BME-SBT/canbrd/README.md

# canbrd
Universal CAN enabled MCU board
