BME-SBT/canbrd/hardware/hardware.html

# /home/lord/DEV/Solar/canbrd/hardware/hardware.sch

2021. aug. 20., péntek, 15:23:27 CEST

Eeschema 5.1.10-88a1d61d58~88~ubuntu20.04.1

Component Count:71

Ref | Qnty | Value | Part | Footprint | Description | Vendor
C1, C5 | 2 | 100n | Device:C_Small | | Unpolarized capacitor, small symbol
C2, C6 | 2 | 68u | Device:CP_Small | | Polarized capacitor, small symbol
C3, C4 | 2 | 10u | Device:C_Small | Capacitor_SMD:C_0805_2012Metric | Unpolarized capacitor, small symbol
C7, C8, C9, C10, C11 | 5 | 100n | Device:C_Small | Capacitor_SMD:C_0805_2012Metric | Unpolarized capacitor, small symbol
C12 | 1 | 4u7 | Device:C_Small | Capacitor_SMD:C_0805_2012Metric | Unpolarized capacitor, small symbol
C13, C16 | 2 | 1u | Device:C_Small | Capacitor_SMD:C_0805_2012Metric | Unpolarized capacitor, small symbol
C14, C15 | 2 | 10n | Device:C_Small | Capacitor_SMD:C_0805_2012Metric | Unpolarized capacitor, small symbol
C17, C18 | 2 | TBD | Device:C_Small | Capacitor_SMD:C_0805_2012Metric | Unpolarized capacitor, small symbol
D1, D4 | 2 | D | Device:D | | Diode
D2 | 1 | 10V | Device:D_Zener | | Zener diode
D3 | 1 | SMCJ26CA | Device:D_TVS | | Bidirectional transient-voltage-suppression diode
D5 | 1 | 50SQ100 | Device:D_Schottky_Small | | Schottky diode, small symbol
D6, D7 | 2 | TBU-CA040-200-WH | TBU-CA065-200-WH:TBU-CA065-200-WH | DIOC650X400X100N
D8 | 1 | NUP2105L | Power_Protection:NUP2105L | Package_TO_SOT_SMD:SOT-23 | Dual Line CAN Bus Protector, 24Vrwm
D9 | 1 | LTD-4708G | LTD-4708G:LTD-4708G | LTD-470:LED_LTD-4708G
D10 | 1 | RED | Device:LED | LED_SMD:LED_0805_2012Metric | Light emitting diode
D11 | 1 | GREEN | Device:LED | LED_SMD:LED_0805_2012Metric | Light emitting diode
D12 | 1 | BLUE | Device:LED | LED_SMD:LED_0805_2012Metric | Light emitting diode
F1, F3 | 2 | 200mA | Device:Fuse | | Fuse
F2 | 1 | 200mA | Device:Polyfuse | | Resettable fuse, polymeric positive temperature coefficient
FB1 | 1 | 1k@100MHz | Device:Ferrite_Bead | | Ferrite bead
FB2 | 1 | 1k@100MHz | Device:Ferrite_Bead_Small | Inductor_SMD:L_0805_2012Metric | Ferrite bead, small symbol
J1 | 1 | USB_C_Receptacle_USB2.0 | Connector:USB_C_Receptacle_USB2.0 | | USB 2.0-only Type-C Receptacle connector
J2 | 1 | Conn_ST_STDC14 | Connector:Conn_ST_STDC14 | | ST Debug Connector, standard ARM Cortex-M SWD and JTAG interface plus UART
JP1 | 1 | CC1 | Jumper:Jumper_3_Bridged12 | | Jumper, 3-pole, pins 1+2 closed/bridged
JP2 | 1 | CC2 | Jumper:Jumper_3_Bridged12 | | Jumper, 3-pole, pins 1+2 closed/bridged
JP3 | 1 | Jumper_2_Bridged | Jumper:Jumper_2_Bridged | Jumper:SolderJumper-2_P1.3mm_Bridged_RoundedPad1.0x1.5mm | Jumper, 2-pole, closed/bridged
L1 | 1 | 100u | Device:L | | Inductor
Q1 | 1 | Si3129DV | Si3129DV:Si3129DV | Package_SO:TSOP-6_1.65x3.05mm_P0.95mm | P-MOSFET transistor, source/drain/gate, drain connected to mounting plane
Q2 | 1 | PMDT290UNE | Device:Q_DUAL_NMOS_S1G1D2S2G2D1 | Package_TO_SOT_SMD:SOT-666 | Dual NMOS transistor, 6 pin package
R1 | 1 | 1M | Device:R_Small | | Resistor, small symbol
R2 | 1 | 68k | Device:R | | Resistor
R3 | 1 | 384k | Device:R_Small | | Resistor, small symbol
R4 | 1 | 10k | Device:R | | Resistor
R5, R6 | 2 | 5k1 | Device:R | | Resistor
R7, R8, R9, R10, R11, R13, R16, R17 | 8 | 560 | Device:R_Small | Resistor_SMD:R_0805_2012Metric | Resistor, small symbol
R12, R14, R15 | 3 | TBD | Device:R_Small | Resistor_SMD:R_0805_2012Metric | Resistor, small symbol
RV1 | 1 | 60V | Device:Varistor | | Voltage dependent resistor
SW1 | 1 | GDH08S04 | Switch:SW_DIP_x08 | GDH08S04:SOIC127P813X256-16N | 8x DIP Switch, Single Pole Single Throw (SPST) switch, small symbol
SW2 | 1 | RST | Switch:SW_Push | Button_Switch_SMD:SW_SPST_B3U-1000P | Push button switch, generic, two pins
SW3 | 1 | BOOT0 | Switch:SW_Push | Button_Switch_SMD:SW_SPST_B3U-1000P | Push button switch, generic, two pins
SW4 | 1 | USR | Switch:SW_Push | Button_Switch_SMD:SW_SPST_B3U-1000P | Push button switch, generic, two pins
U1 | 1 | MAX5035BUSA | Regulator_Switching:MAX5035BUSA | Package_SO:SOIC-8_3.9x4.9mm_P1.27mm | 1A, High-Efficiency Step-Down DC-DC Converter, 5V fixed output voltage, Vin 76V, SO-8
U2 | 1 | NCP1117-3.3_SOT223 | Regulator_Linear:NCP1117-3.3_SOT223 | Package_TO_SOT_SMD:SOT-223-3_TabPin2 | 1A Low drop-out regulator, Fixed Output 3.3V, SOT-223
U3 | 1 | TCAN1051HGV | TCAN1051HGV:TCAN1051HGV | Package_SO:SOIC-8_3.9x4.9mm_P1.27mm | TCAN1051HGV Fault Protected CAN Transceiver with CAN FD
U4 | 1 | USBLC6-4SC6 | Power_Protection:USBLC6-4SC6 | Package_TO_SOT_SMD:SOT-23-6 | Very low capacitance ESD protection diode, 4 data-line, SOT-23-6
U5 | 1 | STM32G474VET6 | STM32G474VET6:STM32G474VET6 | Package_QFP:TQFP-100_14x14mm_P0.5mm
Y1 | 1 | 25MHz | Device:Crystal_GND24_Small | Crystal:Crystal_SMD_3225-4Pin_3.2x2.5mm_HandSoldering | Four pin crystal, GND on pins 2 and 4, small symbol
