BME-SBT/canbrd/docs/mcu_100.xlsx

Sheet: List
Favorite | Part No | Reference | Unit Price for 10kU (US$) | Package | Flash | RAM | IO | Freq. | ADC 12-bit | CAN | DAC 12-bit | I2C | RTC | SPI | Timer 16-bit | Timer 32-bit | UART | USART | USB Device | USB OTG_FS | USB OTG_HS
1 | STM32F205VE | STM32F205VETx | 4.33 | LQFP100 (14x14mm) | 512 kBytes | 128 kBytes | 82 | 120 MHz | 16 | 2 | 2 | 3 | 1 | 3 | 12 | 2 | 2 | 4 | 0 | 1 | 1
1 | STM32F205VF | STM32F205VFTx | 4.792 | LQFP100 (14x14mm) | 768 kBytes | 128 kBytes | 82 | 120 MHz | 16 | 2 | 2 | 3 | 1 | 3 | 12 | 2 | 2 | 4 | 0 | 1 | 1
1 | STM32F205VG | STM32F205VGTx | 5.255 | LQFP100 (14x14mm) | 1024 kBytes | 128 kBytes | 82 | 120 MHz | 16 | 2 | 2 | 3 | 1 | 3 | 12 | 2 | 2 | 4 | 0 | 1 | 1
1 | STM32F207VE | STM32F207VETx | 4.7 | LQFP100 (14x14mm) | 512 kBytes | 128 kBytes | 82 | 120 MHz | 16 | 2 | 2 | 3 | 1 | 3 | 12 | 2 | 2 | 4 | 0 | 1 | 1
1 | STM32F207VF | STM32F207VFTx | 5.163 | LQFP100 (14x14mm) | 768 kBytes | 128 kBytes | 82 | 120 MHz | 16 | 2 | 2 | 3 | 1 | 3 | 12 | 2 | 2 | 4 | 0 | 1 | 1
1 | STM32F207VG | STM32F207VGTx | 5.626 | LQFP100 (14x14mm) | 1024 kBytes | 128 kBytes | 82 | 120 MHz | 16 | 2 | 2 | 3 | 1 | 3 | 12 | 2 | 2 | 4 | 0 | 1 | 1
1 | STM32F215VE | STM32F215VETx | 4.677 | LQFP100 (14x14mm) | 512 kBytes | 128 kBytes | 82 | 120 MHz | 16 | 2 | 2 | 3 | 1 | 3 | 12 | 2 | 2 | 4 | 0 | 1 | 1
1 | STM32F215VG | STM32F215VGTx | 5.602 | LQFP100 (14x14mm) | 1024 kBytes | 128 kBytes | 82 | 120 MHz | 16 | 2 | 2 | 3 | 1 | 3 | 12 | 2 | 2 | 4 | 0 | 1 | 1
1 | STM32F217VE | STM32F217VETx | 5.047 | LQFP100 (14x14mm) | 512 kBytes | 128 kBytes | 82 | 120 MHz | 16 | 2 | 2 | 3 | 1 | 3 | 12 | 2 | 2 | 4 | 0 | 1 | 1
1 | STM32F217VG | STM32F217VGTx | 5.973 | LQFP100 (14x14mm) | 1024 kBytes | 128 kBytes | 82 | 120 MHz | 16 | 2 | 2 | 3 | 1 | 3 | 12 | 2 | 2 | 4 | 0 | 1 | 1
3 | STM32F405VG | STM32F405VGTx | 5.283 | LQFP100 (14x14mm) | 1024 kBytes | 192 kBytes | 82 | 168 MHz | 16 | 2 | 2 | 3 | 1 | 3 | 12 | 2 | 2 | 4 | 0 | 1 | 1
4 | STM32F407VE | STM32F407VETx | 4.772 | LQFP100 (14x14mm) | 512 kBytes | 192 kBytes | 82 | 168 MHz | 16 | 2 | 2 | 3 | 1 | 3 | 12 | 2 | 2 | 4 | 0 | 1 | 1
5 | STM32F407VG | STM32F407VGTx | 5.623 | LQFP100 (14x14mm) | 1024 kBytes | 192 kBytes | 82 | 168 MHz | 16 | 2 | 2 | 3 | 1 | 3 | 12 | 2 | 2 | 4 | 0 | 1 | 1
2 | STM32F413VG | STM32F413VGTx | 4.816 | LQFP100 (14x14mm) | 1024 kBytes | 320 kBytes | 81 | 100 MHz | 16 | 3 | 2 | 3 | 1 | 5 | 12 | 2 | 6 | 4 | 0 | 1 | 0
2 | STM32F413VH | STM32F413VHTx | 5.348 | LQFP100 (14x14mm) | 1536 kBytes | 320 kBytes | 81 | 100 MHz | 16 | 3 | 2 | 3 | 1 | 5 | 12 | 2 | 6 | 4 | 0 | 1 | 0
3 | STM32F415VG | STM32F415VGTx | 5.602 | LQFP100 (14x14mm) | 1024 kBytes | 192 kBytes | 82 | 168 MHz | 16 | 2 | 2 | 3 | 1 | 3 | 12 | 2 | 2 | 4 | 0 | 1 | 1
4 | STM32F417VE | STM32F417VETx | 5.091 | LQFP100 (14x14mm) | 512 kBytes | 192 kBytes | 82 | 168 MHz | 16 | 2 | 2 | 3 | 1 | 3 | 12 | 2 | 2 | 4 | 0 | 1 | 1
5 | STM32F417VG | STM32F417VGTx | 5.943 | LQFP100 (14x14mm) | 1024 kBytes | 192 kBytes | 82 | 168 MHz | 16 | 2 | 2 | 3 | 1 | 3 | 12 | 2 | 2 | 4 | 0 | 1 | 1
2 | STM32F423VH | STM32F423VHTx | 5.667 | LQFP100 (14x14mm) | 1536 kBytes | 320 kBytes | 81 | 100 MHz | 16 | 3 | 2 | 3 | 1 | 5 | 12 | 2 | 6 | 4 | 0 | 1 | 0
5 | STM32F427VG | STM32F427VGTx | 5.848 | LQFP100 (14x14mm) | 1024 kBytes | 256 kBytes | 82 | 180 MHz | 16 | 2 | 2 | 3 | 1 | 4 | 12 | 2 | 4 | 4 | 0 | 1 | 1
5 | STM32F427VI | STM32F427VITx | 6.7 | LQFP100 (14x14mm) | 2048 kBytes | 256 kBytes | 82 | 180 MHz | 16 | 2 | 2 | 3 | 1 | 4 | 12 | 2 | 4 | 4 | 0 | 1 | 1
4 | STM32F429VE | STM32F429VETx | 5.295 | LQFP100 (14x14mm) | 512 kBytes | 256 kBytes | 82 | 180 MHz | 16 | 2 | 2 | 3 | 1 | 4 | 12 | 2 | 4 | 4 | 0 | 1 | 1
5 | STM32F429VG | STM32F429VGTx | 6.146 | LQFP100 (14x14mm) | 1024 kBytes | 256 kBytes | 82 | 180 MHz | 16 | 2 | 2 | 3 | 1 | 4 | 12 | 2 | 4 | 4 | 0 | 1 | 1
5 | STM32F429VI | STM32F429VITx | 6.998 | LQFP100 (14x14mm) | 2048 kBytes | 256 kBytes | 82 | 180 MHz | 16 | 2 | 2 | 3 | 1 | 4 | 12 | 2 | 4 | 4 | 0 | 1 | 1
5 | STM32F437VG | STM32F437VGTx | 6.168 | LQFP100 (14x14mm) | 1024 kBytes | 256 kBytes | 82 | 180 MHz | 16 | 2 | 2 | 3 | 1 | 4 | 12 | 2 | 4 | 4 | 0 | 1 | 1
5 | STM32F437VI | STM32F437VITx | 7.019 | LQFP100 (14x14mm) | 2048 kBytes | 256 kBytes | 82 | 180 MHz | 16 | 2 | 2 | 3 | 1 | 4 | 12 | 2 | 4 | 4 | 0 | 1 | 1
5 | STM32F439VG | STM32F439VGTx | 6.466 | LQFP100 (14x14mm) | 1024 kBytes | 256 kBytes | 82 | 180 MHz | 16 | 2 | 2 | 3 | 1 | 4 | 12 | 2 | 4 | 4 | 0 | 1 | 1
5 | STM32F439VI | STM32F439VITx | 7.317 | LQFP100 (14x14mm) | 2048 kBytes | 256 kBytes | 82 | 180 MHz | 16 | 2 | 2 | 3 | 1 | 4 | 12 | 2 | 4 | 4 | 0 | 1 | 1
4 | STM32F446VE | STM32F446VETx | 3.982 | LQFP100 (14x14mm) | 512 kBytes | 128 kBytes | 81 | 180 MHz | 16 | 2 | 2 | 3 | 1 | 4 | 12 | 2 | 2 | 4 | 0 | 1 | 1
2 | STM32F722VE | STM32F722VETx | 4.685 | LQFP100 (14x14mm) | 512 kBytes | 256 kBytes | 82 | 216 MHz | 16 | 1 | 2 | 3 | 1 | 4 | 12 | 2 | 4 | 4 | 0 | 1 | 1
2 | STM32F723VC | STM32F723VCTx | 4.429 | LQFP100 (14x14mm) | 512 kBytes | 256 kBytes | 79 | 216 MHz | 16 | 1 | 2 | 3 | 1 | 4 | 11 | 2 | 4 | 4 | 0 | 1 | 1
2 | STM32F723VE | STM32F723VETx | 4.685 | LQFP100 (14x14mm) | 512 kBytes | 256 kBytes | 79 | 216 MHz | 16 | 1 | 2 | 3 | 1 | 4 | 11 | 2 | 4 | 4 | 0 | 1 | 1
2 | STM32F732VE | STM32F732VETx | 4.791 | LQFP100 (14x14mm) | 512 kBytes | 256 kBytes | 82 | 216 MHz | 16 | 1 | 2 | 3 | 1 | 4 | 12 | 2 | 4 | 4 | 0 | 1 | 1
2 | STM32F733VE | STM32F733VETx | 5.11 | LQFP100 (14x14mm) | 512 kBytes | 256 kBytes | 79 | 216 MHz | 16 | 1 | 2 | 3 | 1 | 4 | 11 | 2 | 4 | 4 | 0 | 1 | 1
4 | STM32F745VE | STM32F745VETx | 5.114 | LQFP100 (14x14mm) | 512 kBytes | 320 kBytes | 82 | 216 MHz | 16 | 2 | 2 | 4 | 1 | 4 | 12 | 2 | 4 | 4 | 0 | 1 | 1
5 | STM32F745VG | STM32F745VGTx | 5.965 | LQFP100 (14x14mm) | 1024 kBytes | 320 kBytes | 82 | 216 MHz | 16 | 2 | 2 | 4 | 1 | 4 | 12 | 2 | 4 | 4 | 0 | 1 | 1
4 | STM32F746VE | STM32F746VETx | 5.412 | LQFP100 (14x14mm) | 512 kBytes | 320 kBytes | 82 | 216 MHz | 16 | 2 | 2 | 4 | 1 | 4 | 12 | 2 | 4 | 4 | 0 | 1 | 1
5 | STM32F746VG | STM32F746VGTx | 6.263 | LQFP100 (14x14mm) | 1024 kBytes | 320 kBytes | 82 | 216 MHz | 16 | 2 | 2 | 4 | 1 | 4 | 12 | 2 | 4 | 4 | 0 | 1 | 1
5 | STM32F756VG | STM32F756VGTx | 6.583 | LQFP100 (14x14mm) | 1024 kBytes | 320 kBytes | 82 | 216 MHz | 16 | 2 | 2 | 4 | 1 | 4 | 12 | 2 | 4 | 4 | 0 | 1 | 1
5 | STM32F765VG | STM32F765VGTx | 6.346 | LQFP100 (14x14mm) | 1024 kBytes | 512 kBytes | 82 | 216 MHz | 16 | 3 | 2 | 4 | 1 | 5 | 12 | 2 | 4 | 4 | 0 | 1 | 1
5 | STM32F765VI | STM32F765VITx | 7.198 | LQFP100 (14x14mm) | 2048 kBytes | 512 kBytes | 82 | 216 MHz | 16 | 3 | 2 | 4 | 1 | 5 | 12 | 2 | 4 | 4 | 0 | 1 | 1
5 | STM32F767VG | STM32F767VGTx | 6.577 | LQFP100 (14x14mm) | 1024 kBytes | 512 kBytes | 82 | 216 MHz | 16 | 3 | 2 | 4 | 1 | 5 | 12 | 2 | 4 | 4 | 0 | 1 | 1
5 | STM32F767VI | STM32F767VITx | 7.428 | LQFP100 (14x14mm) | 2048 kBytes | 512 kBytes | 82 | 216 MHz | 16 | 3 | 2 | 4 | 1 | 5 | 12 | 2 | 4 | 4 | 0 | 1 | 1
5 | STM32F777VI | STM32F777VITx | 7.747 | LQFP100 (14x14mm) | 2048 kBytes | 512 kBytes | 82 | 216 MHz | 16 | 3 | 2 | 4 | 1 | 5 | 12 | 2 | 4 | 4 | 0 | 1 | 1
3 | STM32L4P5VE | STM32L4P5VETx | 3.921 | LQFP100 (14x14mm) | 512 kBytes | 320 kBytes | 83 | 120 MHz | 16 | 1 | 2 | 4 | 1 | 3 | 9 | 2 | 2 | 3 | 0 | 1 | 0
4 | STM32L4R5VG | STM32L4R5VGTx | 5.675 | LQFP100 (14x14mm) | 1024 kBytes | 640 kBytes | 83 | 120 MHz | 16 | 1 | 2 | 4 | 1 | 3 | 9 | 2 | 2 | 3 | 0 | 1 | 0
4 | STM32L4R5VI | STM32L4R5VITx | 6.527 | LQFP100 (14x14mm) | 2048 kBytes | 640 kBytes | 83 | 120 MHz | 16 | 1 | 2 | 4 | 1 | 3 | 9 | 2 | 2 | 3 | 0 | 1 | 0
4 | STM32L4R7VI | STM32L4R7VITx | 6.846 | LQFP100 (14x14mm) | 2048 kBytes | 640 kBytes | 83 | 120 MHz | 16 | 1 | 2 | 4 | 1 | 3 | 9 | 2 | 2 | 3 | 0 | 1 | 0
4 | STM32L4S5VI | STM32L4S5VITx | 6.633 | LQFP100 (14x14mm) | 2048 kBytes | 640 kBytes | 83 | 120 MHz | 16 | 1 | 2 | 4 | 1 | 3 | 9 | 2 | 2 | 3 | 0 | 1 | 0
4 | STM32L4S7VI | STM32L4S7VITx | 6.952 | LQFP100 (14x14mm) | 2048 kBytes | 640 kBytes | 83 | 120 MHz | 16 | 1 | 2 | 4 | 1 | 3 | 9 | 2 | 2 | 3 | 0 | 1 | 0
4 | STM32G473VE | STM32G473VETx | 3.97 | LQFP100 (14x14mm) | 512 kBytes | 128 kBytes | 86 | 170 MHz | 42 | 0 | 3 | 4 | 1 | 4 | 10 | 2 | 2 | 3 | 1 | 0 | 0
4 | STM32G474VE | STM32G474VETx | 4.08 | LQFP100 (14x14mm) | 512 kBytes | 128 kBytes | 86 | 170 MHz | 42 | 0 | 3 | 4 | 1 | 4 | 10 | 2 | 2 | 3 | 1 | 0 | 0
4 | STM32G483VE | STM32G483VETx | 4.085 | LQFP100 (14x14mm) | 512 kBytes | 128 kBytes | 86 | 170 MHz | 42 | 0 | 3 | 4 | 1 | 4 | 10 | 2 | 2 | 3 | 1 | 0 | 0
4 | STM32G484VE | STM32G484VETx | 4.196 | LQFP100 (14x14mm) | 512 kBytes | 128 kBytes | 86 | 170 MHz | 42 | 0 | 3 | 4 | 1 | 4 | 10 | 2 | 2 | 3 | 1 | 0 | 0

Sheet: Filters
Filter | Value | User Selected
BigFamily | STM32 | Y
Package | LQFP100 (14x14mm) | Y
Core | Arm Cortex-M3, Arm Cortex-M4, Arm Cortex-M7 | N
Series | STM32F2, STM32F4, STM32F7, STM32L4+ | N
Line | STM32F2x5, STM32F2x7, STM32F405/415, STM32F407/417, STM32F413/423, STM32F427/437, STM32F429/439, STM32F446, STM32F7x2, STM32F7x3, STM32F7x5, STM32F7x6, STM32F7x7, STM32L4P5/Q5, STM32L4R5/S5, STM32L4R7/S7 | N
Freq | 100 to 216 | Y
Flash | 512 to 2048 | Y
Ram | 128 to 640 | Y
Price | 3.921 to 7.747 | N
IO | 79 to 83 | N
Eeprom | 0 to 0 | N
ADC 12-bit | 16 | Y
AES | 0 | N
CAN | 1 | Y
COMP | 0 | N
DAC 12-bit | 1 | Y
DCMI | 0 | N
DES/TDES | 0 | N
DFSDM | 0 | N
Ethernet | 0 | N
FMC | 0 | N
FMPI2C | 0 | N
FSMC | 0 | N
HDMI CEC | 0 | N
HMAC | 0 | N
I2C | 0 | N
I2S | 0 | N
IRTIM | 0 | N
LPTIM | 0 | N
LPUART | 0 | N
MD5 | 0 | N
OPAMP | 0 | N
QUADSPI | 0 | N
RTC | 0 | N
SAI | 0 | N
SDIO | 0 | N
SDMMC | 0 | N
SHA | 0 | N
SPDIFRX | 0 | N
SPI | 0 | N
TFT LCD | 0 | N
TRNG | 0 | N
Timer 16-bit | 0 | N
Timer 32-bit | 0 | N
Touch Sensing | 0 | N
UART | 0 | N
USART | 0 | N
USB OTG_FS | 0 | N
USB OTG_HS | 0 | N
