BME-SBT/canbrd/docs/mcu_100_g4.xlsx

Sheet: List
List of MCUs selection: 4 items. Database version: Mon Jun 07 10:53:21 CEST 2021
Favorite | Part No | Reference | Unit Price for 10kU (US$) | Package | Flash | RAM | IO | Freq. | ADC 12-bit | ADC 16-bit | CAN | DAC 12-bit | I2C | RTC | SPI | Timer 16-bit | Timer 32-bit | UART | USART | USB Device | USB OTG_FS | USB OTG_HS
 | STM32G473VE | STM32G473VETx | 3.97 | LQFP100 (14x14mm) | 512 kBytes | 128 kBytes | 86 | 170 MHz | 42 | 0 | 0 | 3 | 4 | 1 | 4 | 10 | 2 | 2 | 3 | 1 | 0 | 0
* | STM32G474VE | STM32G474VETx | 4.08 | LQFP100 (14x14mm) | 512 kBytes | 128 kBytes | 86 | 170 MHz | 42 | 0 | 0 | 3 | 4 | 1 | 4 | 10 | 2 | 2 | 3 | 1 | 0 | 0
 | STM32G483VE | STM32G483VETx | 4.085 | LQFP100 (14x14mm) | 512 kBytes | 128 kBytes | 86 | 170 MHz | 42 | 0 | 0 | 3 | 4 | 1 | 4 | 10 | 2 | 2 | 3 | 1 | 0 | 0
 | STM32G484VE | STM32G484VETx | 4.196 | LQFP100 (14x14mm) | 512 kBytes | 128 kBytes | 86 | 170 MHz | 42 | 0 | 0 | 3 | 4 | 1 | 4 | 10 | 2 | 2 | 3 | 1 | 0 | 0

Sheet: Filters
List of MCUs selection: 4 items. Database version: Mon Jun 07 10:53:21 CEST 2021
Filter | Value | User Selected
BigFamily | STM32 | Y
Package | LQFP100 (14x14mm) | Y
Series | STM32G4 | Y
Core | Arm Cortex-M4 | N
Line | STM32G4x3, STM32G4x4 | N
Freq | 100 to 216 | Y
Flash | 512 to 2048 | Y
Ram | 128 to 640 | Y
Price | 3.97 to 4.196 | N
IO | 86 to 86 | N
Eeprom | 0 to 0 | N
ADC 12-bit | 0 | N
AES | 0 | N
COMP | 0 | N
DAC 12-bit | 0 | N
FMC | 0 | N
HRTIM | 0 | N
I2C | 0 | N
I2S | 0 | N
IRTIM | 0 | N
LPTIM | 0 | N
LPUART | 0 | N
OPAMP | 0 | N
QUADSPI | 0 | N
RTC | 0 | N
SAI | 0 | N
SPI | 0 | N
Timer 16-bit | 0 | N
Timer 32-bit | 0 | N
UART | 0 | N
USART | 0 | N
USB Device | 0 | N
