BME-SBT/canbrd/docs/can_transciever.xlsx

Manufacturer | Part No. | Max data rate | Isolation | Iso Power | Common V | Bus Fault V | ESD V | Price | Price w/ iso | Lead time | power iso | 1000 Ft | PDP1-S5-S5-M
Analog | ADM3057E | 12M | 3.00 kVrms | Y | ±25 V | ±40 V |  | 3600 Ft | 3600 Ft | short | io iso | 600 Ft
Analog | ADM3055E | 12M | 5.00 kVrms | Y | ±25 V | ±40 V |  | 4200 Ft | 4200 Ft | short | power+io iso | 2000 Ft | ADuM5211
Analog | ADM3050E | 12M | 5.70 kVrms |  | ±25 V | ±40 V |  | 1600 Ft | 2600 Ft | short
Analog | ADM3058E | 12M | 5.70 kVrms |  | ±25 V | ±40 V | 15 kV | 1600 Ft | 2600 Ft | LONG
NXP | TJA1052i | 5M | 5.00 kVrms |  | ±25 V | ±58 V | 8 kV | 2100 Ft | 3100 Ft | LONG
NXP | TJA1042T | 5M |  |  |  | ±58 V | 8 kV | 450 Ft | 2450 Ft | LONG
NXP | TJA1049T | 5M |  |  |  | ±58 V | 8 kV | 500 Ft | 2500 Ft | LONG
NXP | TJA1051T | 5M |  |  |  | ±58 V | 8 kV | 380 Ft | 2380 Ft | LONG
Microchip | MCP2558FD | 8M |  |  |  | ±58 V | 8 kV | 250 Ft | 2250 Ft | short
Texas Instruments | ISO1042 | 5M | 5.00 kVrms |  | ±30 V | ±70 V | 16 kV | 1500 Ft | 2500 Ft | long
Texas Instruments | TCAN1042HGV | 5M |  |  | ±30 V | ±70 V | 15 kV | 600 Ft | 2600 Ft | mid
Texas Instruments | TCAN1051HGV | 5M |  |  | ±30 V | ±70 V | 15 kV | 600 Ft | 2600 Ft | mid
