BME-SBT/canbrd/docs/mcu_g4.xlsx

Sheet: List
List of MCUs selection: 15 items. Database version: Mon Jun 07 10:53:21 CEST 2021
Favorite | Part No | Reference | Unit Price for 10kU (US$) | Package | Flash | RAM | IO | Freq. | ADC 12-bit | CAN | DAC 12-bit | I2C | RTC | SPI | Timer 16-bit | Timer 32-bit | UART | USART | USB Device | USB OTG_FS | USB OTG_HS
 | STM32G431V6 | STM32G431V6Tx | 2.459 | LQFP100 (14x14mm) | 32 kBytes | 32 kBytes | 86 | 170 MHz | 23 | 0 | 2 | 3 | 1 | 3 | 9 | 1 | 1 | 3 | 1 | 0 | 0
 | STM32G431V8 | STM32G431V8Tx | 2.574 | LQFP100 (14x14mm) | 64 kBytes | 32 kBytes | 86 | 170 MHz | 23 | 0 | 2 | 3 | 1 | 3 | 9 | 1 | 1 | 3 | 1 | 0 | 0
 | STM32G431VB | STM32G431VBTx | 2.76 | LQFP100 (14x14mm) | 128 kBytes | 32 kBytes | 86 | 170 MHz | 23 | 0 | 2 | 3 | 1 | 3 | 9 | 1 | 1 | 3 | 1 | 0 | 0
 | STM32G441VB | STM32G441VBTx | 2.875 | LQFP100 (14x14mm) | 128 kBytes | 32 kBytes | 86 | 170 MHz | 23 | 0 | 2 | 3 | 1 | 3 | 9 | 1 | 1 | 3 | 1 | 0 | 0
 | STM32G473VB | STM32G473VBTx | 3.09 | LQFP100 (14x14mm) | 128 kBytes | 128 kBytes | 86 | 170 MHz | 42 | 0 | 3 | 4 | 1 | 4 | 10 | 2 | 2 | 3 | 1 | 0 | 0
 | STM32G473VC | STM32G473VCTx | 3.414 | LQFP100 (14x14mm) | 256 kBytes | 128 kBytes | 86 | 170 MHz | 42 | 0 | 3 | 4 | 1 | 4 | 10 | 2 | 2 | 3 | 1 | 0 | 0
 | STM32G473VE | STM32G473VETx | 3.97 | LQFP100 (14x14mm) | 512 kBytes | 128 kBytes | 86 | 170 MHz | 42 | 0 | 3 | 4 | 1 | 4 | 10 | 2 | 2 | 3 | 1 | 0 | 0
 | STM32G474VB | STM32G474VBTx | 3.2 | LQFP100 (14x14mm) | 128 kBytes | 128 kBytes | 86 | 170 MHz | 42 | 0 | 3 | 4 | 1 | 4 | 10 | 2 | 2 | 3 | 1 | 0 | 0
 | STM32G474VC | STM32G474VCTx | 3.524 | LQFP100 (14x14mm) | 256 kBytes | 128 kBytes | 86 | 170 MHz | 42 | 0 | 3 | 4 | 1 | 4 | 10 | 2 | 2 | 3 | 1 | 0 | 0
* | STM32G474VE | STM32G474VETx | 4.08 | LQFP100 (14x14mm) | 512 kBytes | 128 kBytes | 86 | 170 MHz | 42 | 0 | 3 | 4 | 1 | 4 | 10 | 2 | 2 | 3 | 1 | 0 | 0
 | STM32G483VE | STM32G483VETx | 4.085 | LQFP100 (14x14mm) | 512 kBytes | 128 kBytes | 86 | 170 MHz | 42 | 0 | 3 | 4 | 1 | 4 | 10 | 2 | 2 | 3 | 1 | 0 | 0
 | STM32G484VE | STM32G484VETx | 4.196 | LQFP100 (14x14mm) | 512 kBytes | 128 kBytes | 86 | 170 MHz | 42 | 0 | 3 | 4 | 1 | 4 | 10 | 2 | 2 | 3 | 1 | 0 | 0
 | STM32G491VC | STM32G491VCTx | 3.084 | LQFP100 (14x14mm) | 256 kBytes | 112 kBytes | 86 | 170 MHz | 36 | 0 | 2 | 3 | 1 | 3 | 10 | 1 | 2 | 3 | 1 | 0 | 0
 | STM32G491VE | STM32G491VETx | 3.639 | LQFP100 (14x14mm) | 512 kBytes | 112 kBytes | 86 | 170 MHz | 36 | 0 | 2 | 3 | 1 | 3 | 10 | 1 | 2 | 3 | 1 | 0 | 0
 | STM32G4A1VE | STM32G4A1VETx | 3.755 | LQFP100 (14x14mm) | 512 kBytes | 112 kBytes | 86 | 170 MHz | 36 | 0 | 2 | 3 | 1 | 3 | 10 | 1 | 2 | 3 | 1 | 0 | 0

Sheet: Filters
List of MCUs selection: 15 items. Database version: Mon Jun 07 10:53:21 CEST 2021
Filter | Value | User Selected
BigFamily | STM32 | Y
Series | STM32G4 | Y
Package | LQFP100 (14x14mm) | Y
Core | Arm Cortex-M4 | N
Line | STM32G4x1, STM32G4x3, STM32G4x4 | N
Price | 2.459 to 4.196 | N
IO | 86 to 86 | N
Eeprom | 0 to 0 | N
Flash | 32 to 512 | N
Ram | 32 to 128 | N
Freq | 170 to 170 | N
ADC 12-bit | 0 | N
AES | 0 | N
COMP | 0 | N
DAC 12-bit | 0 | N
FMC | 0 | N
HRTIM | 0 | N
I2C | 0 | N
I2S | 0 | N
IRTIM | 0 | N
LPTIM | 0 | N
LPUART | 0 | N
OPAMP | 0 | N
QUADSPI | 0 | N
RTC | 0 | N
SAI | 0 | N
SPI | 0 | N
Timer 16-bit | 0 | N
Timer 32-bit | 0 | N
UART | 0 | N
USART | 0 | N
USB Device | 0 | N
