BME-SBT/canbrd/hardware/parts/218-8LPS/218-8.STEP

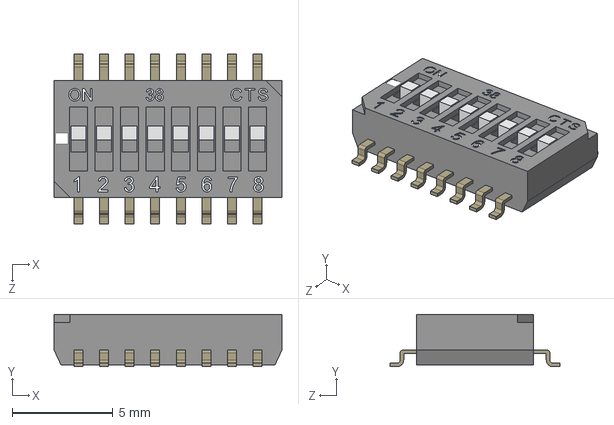
[picture p1: CAD file, 2021-08-23]
hardware/parts/218-8LPS/218-8.STEP
11.3 x 2.60 x 8.44 mm
