BME-SBT/canbrd/hardware/parts/GDH08S04/c-1571983-10-b-3d.stp

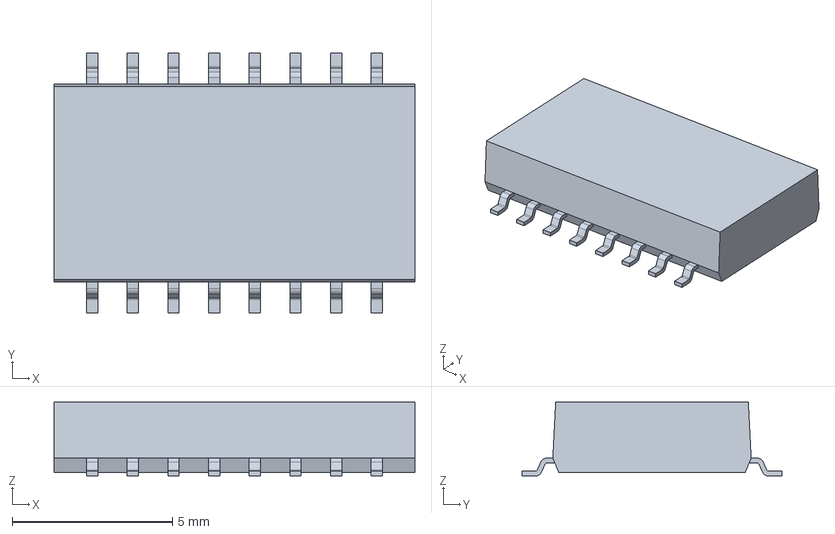
[picture p2: CAD file, 2021-08-17]
hardware/parts/GDH08S04/c-1571983-10-b-3d.stp
11.3 x 8.13 x 2.31 mm
