BME-SBT/canbrd/hardware/parts/Littelfuse-154/0154.500DR.STEP

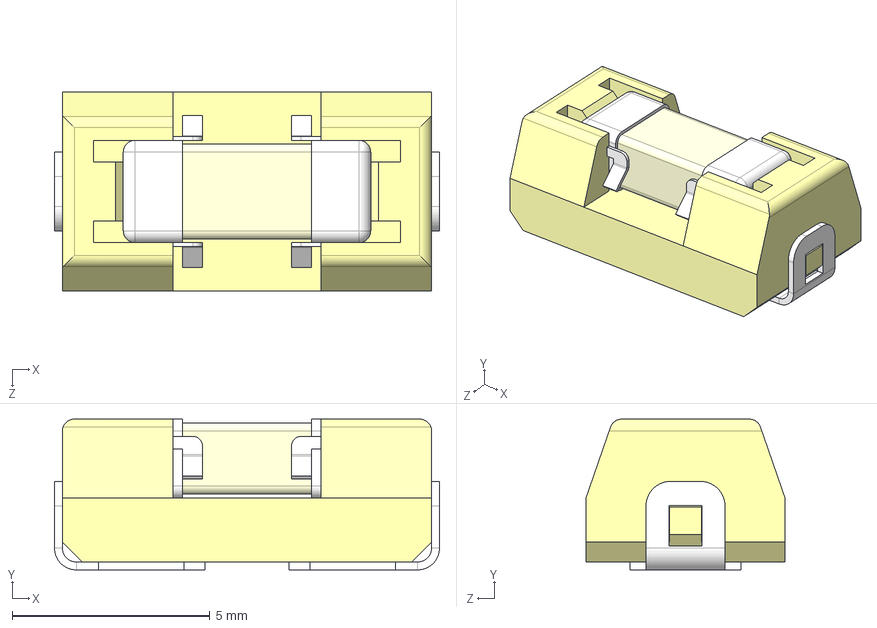
[picture p3: CAD file, 2021-08-23]
hardware/parts/Littelfuse-154/0154.500DR.STEP
9.73 x 3.81 x 5.03 mm
