BME-SBT/canbrd/hardware/parts/LTD-470/LTD-4708G.step

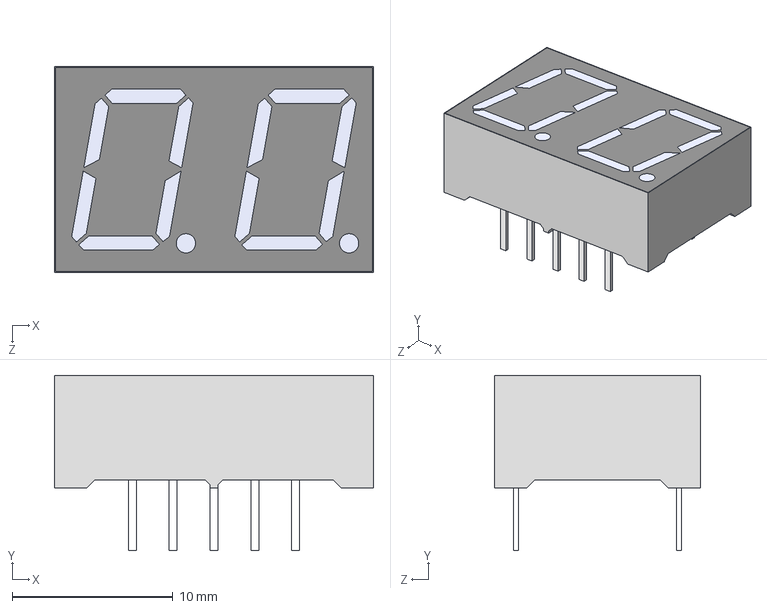
[picture p4: CAD file, 2021-08-17]
hardware/parts/LTD-470/LTD-4708G.step
19.9 x 10.9 x 12.8 mm
