BME-SBT/canbrd/hardware/parts/MAX17521/21-0201A_MXM.step

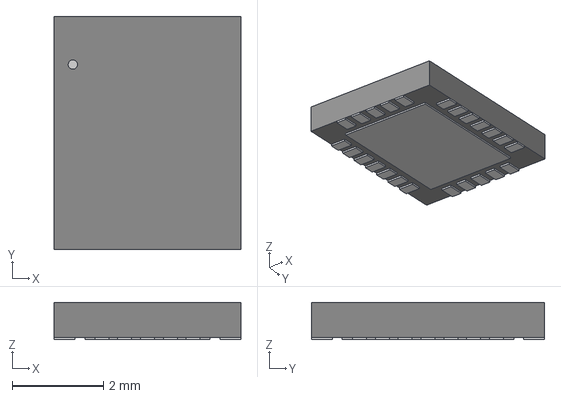
[picture p5: CAD file, 2021-08-22]
hardware/parts/MAX17521/21-0201A_MXM.step
4.09 x 5.11 x 0.815 mm
