BME-SBT/canbrd/hardware/parts/NRS8040/nrs8040.step

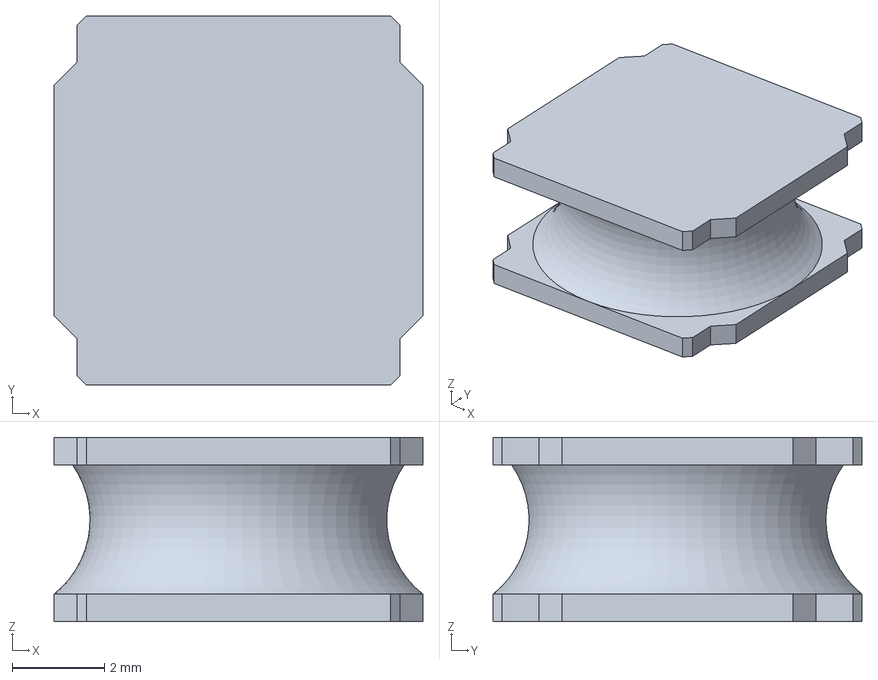
[picture p6: CAD file, 2021-08-23]
hardware/parts/NRS8040/nrs8040.step
8.00 x 8.00 x 4.00 mm
