BME-SBT/canbrd/hardware/parts/RKB2SJ/RKB2SJM250SMTR LFS.stp

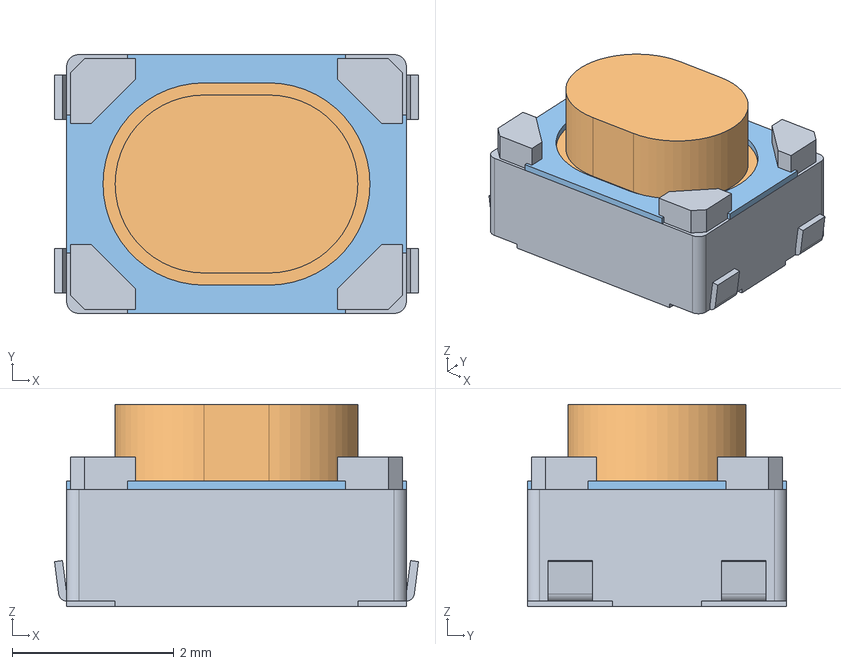
[picture p7: CAD file, 2021-08-23]
hardware/parts/RKB2SJ/RKB2SJM250SMTR LFS.stp
4.50 x 3.20 x 2.50 mm
JIZUO
ANNIU
GAIBAN
