BME-SBT/canbrd/hardware/parts/STM32G474VET6/STM32G474VET6.step

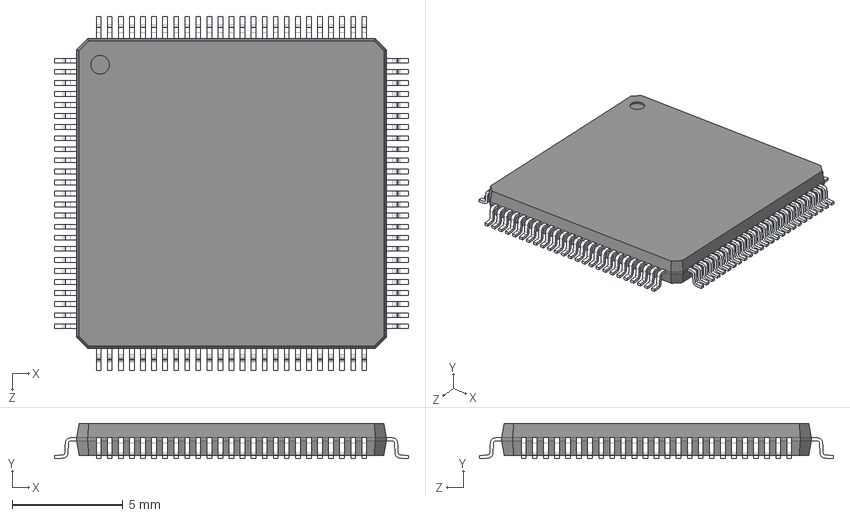
[picture p8: CAD file, 2021-08-16]
hardware/parts/STM32G474VET6/STM32G474VET6.step
16.0 x 1.60 x 16.0 mm
