BME-SBT/canbrd/hardware/parts/TBU-CA/tbu-ca-color.step

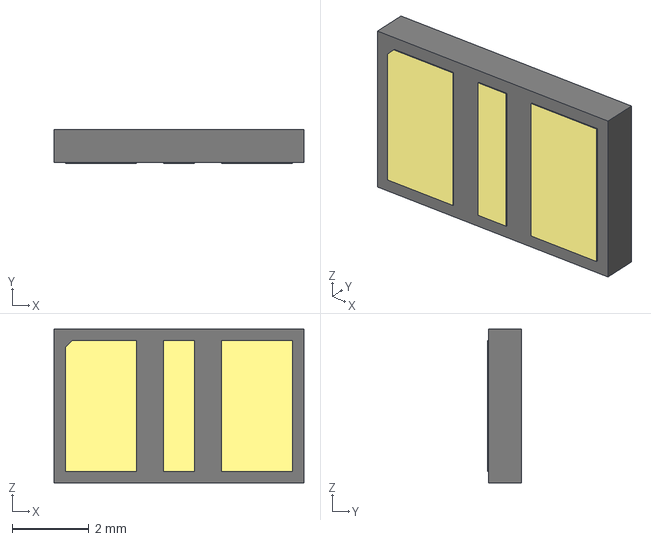
[picture p9: CAD file, 2021-08-23]
hardware/parts/TBU-CA/tbu-ca-color.step
6.50 x 0.875 x 4.00 mm
