BME-SBT/canbrd/hardware/parts/USB4085-GF-A--3DModel-STEP-56544.STEP

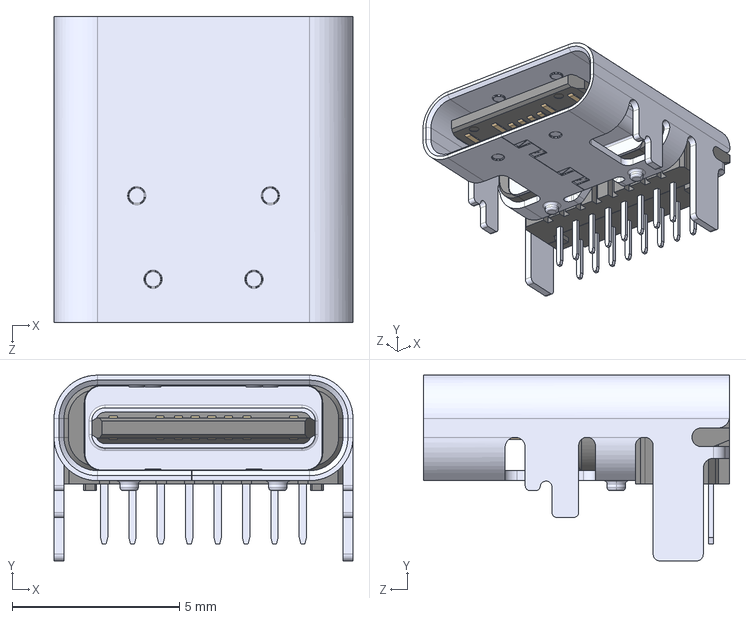
[picture p10: CAD file, 2021-08-23]
hardware/parts/USB4085-GF-A--3DModel-STEP-56544.STEP
8.95 x 5.56 x 9.17 mm
