BME-SBT/canbrd/hardware/parts/0ZCJ0005FF2E.STEP

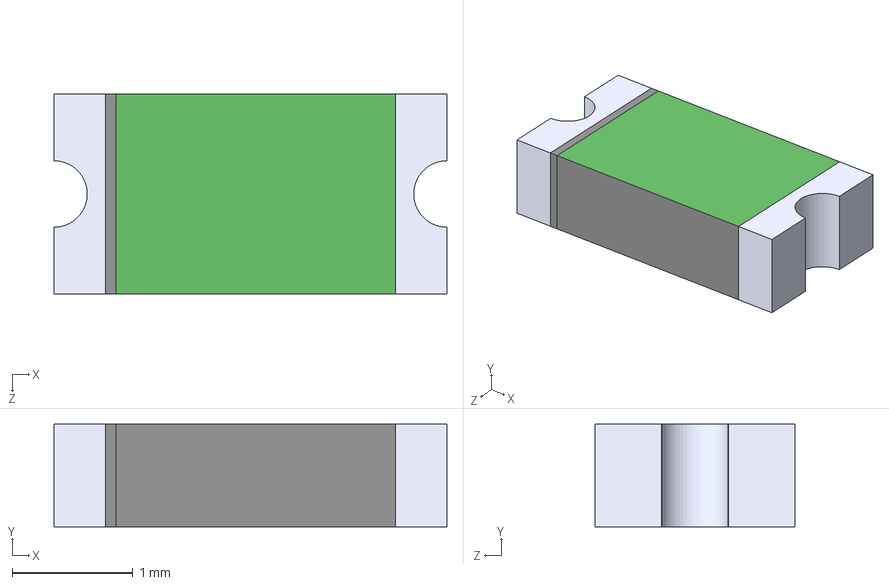
[picture p11: CAD file, 2021-08-23]
hardware/parts/0ZCJ0005FF2E.STEP
3.25 x 0.85 x 1.65 mm
