BME-SBT/canbrd/hardware/parts/71922_y26_asm.stp

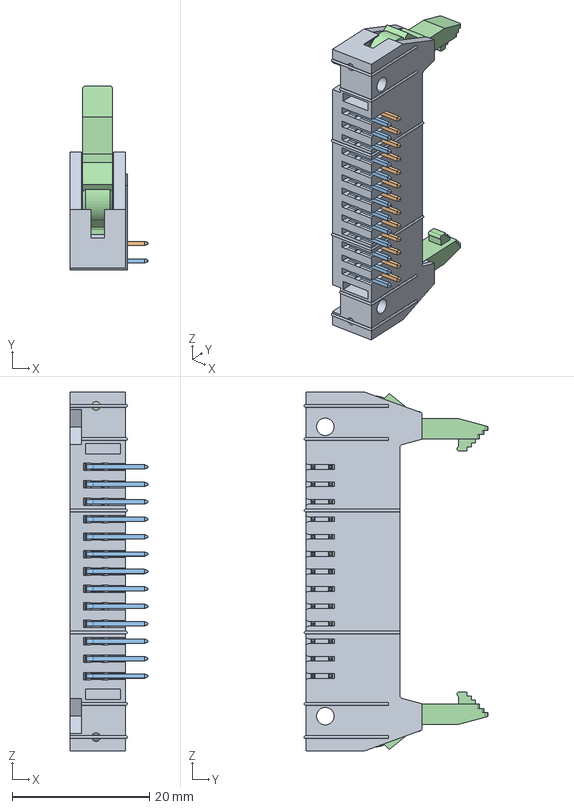
[picture p12: CAD file, 2021-08-23]
hardware/parts/71922_y26_asm.stp
11.4 x 26.8 x 52.3 mm
67017_Y26
77391_Y21 x 13
77391_Y25 x 13
