BME-SBT/canbrd/hardware/parts/OQ0271/OQ0271510000G.step

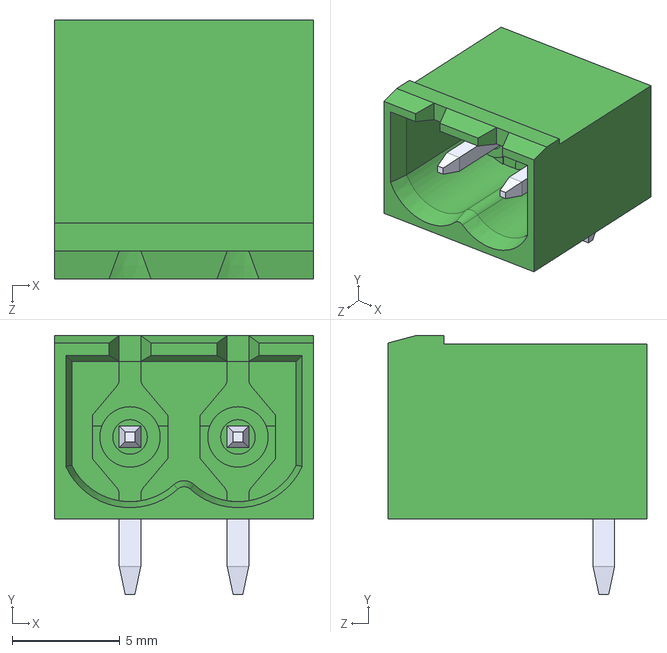
[picture p13: CAD file, 2021-08-23]
hardware/parts/OQ0271/OQ0271510000G.step
12.0 x 12.0 x 12.0 mm
