BME-SBT/canbrd/hardware/parts/Wurth-150080M153000/150080M153000.step

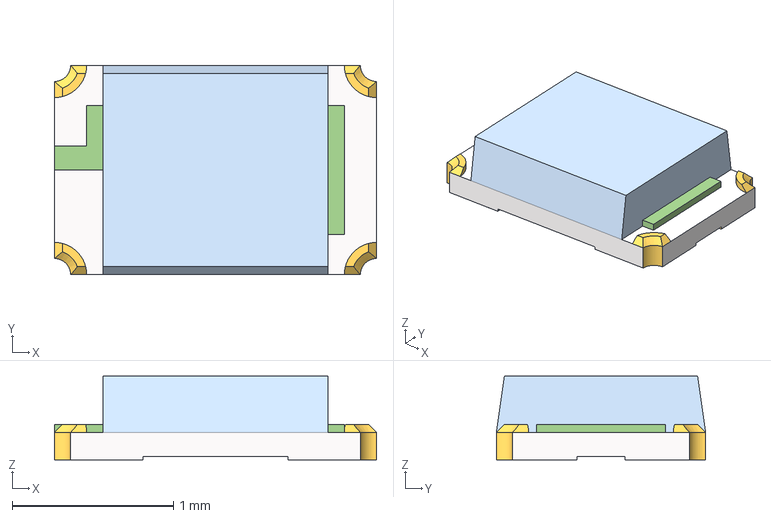
[picture p14: CAD file, 2021-08-17]
hardware/parts/Wurth-150080M153000/150080M153000.step
2.00 x 1.30 x 0.52 mm
