BME-SBT/canbrd/hardware/parts/1040310811.stp

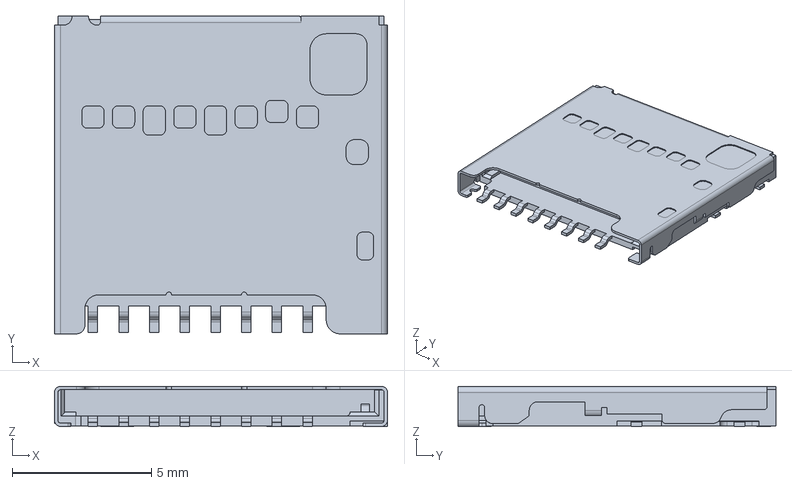
[picture p15: CAD file, 2021-08-23]
hardware/parts/1040310811.stp
11.9 x 11.4 x 1.45 mm
