BME-SBT/canbrd/(list of files, cad)

Other CAD files:
hardware/parts/RKB2SJ/RKB2SJM250SMTR LFS-color.stp
hardware/parts/TBU-CA/tbu-ca.stp
hardware/parts/NRS8040/NRS8040.FCStd
