BME-SBT/canbrd/hardware/hardware.pdf

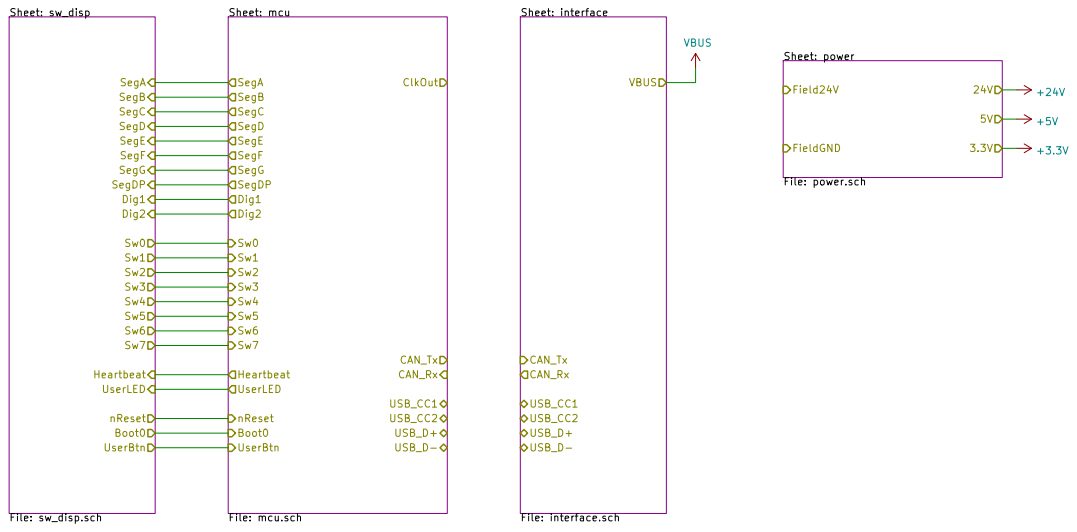
[picture p16: page 1]

File: sw_disp.sch Heartbeat Boot0 UserBtn UserLED

Id: 1/5 Title: File: hardware.sch Sheet: /

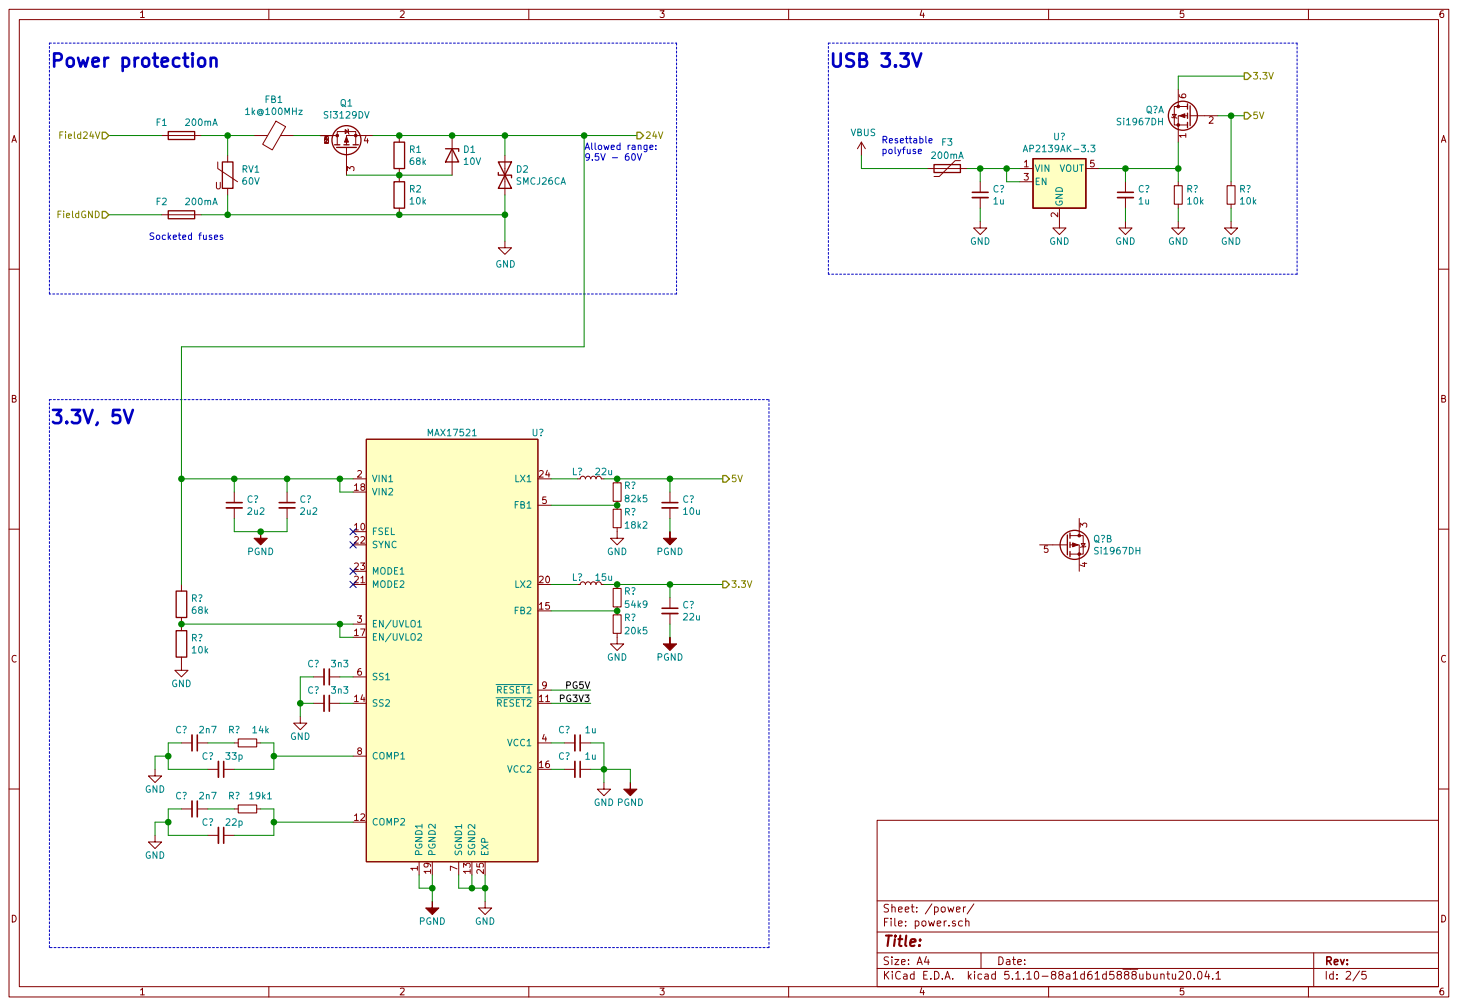
[picture p17: page 2]

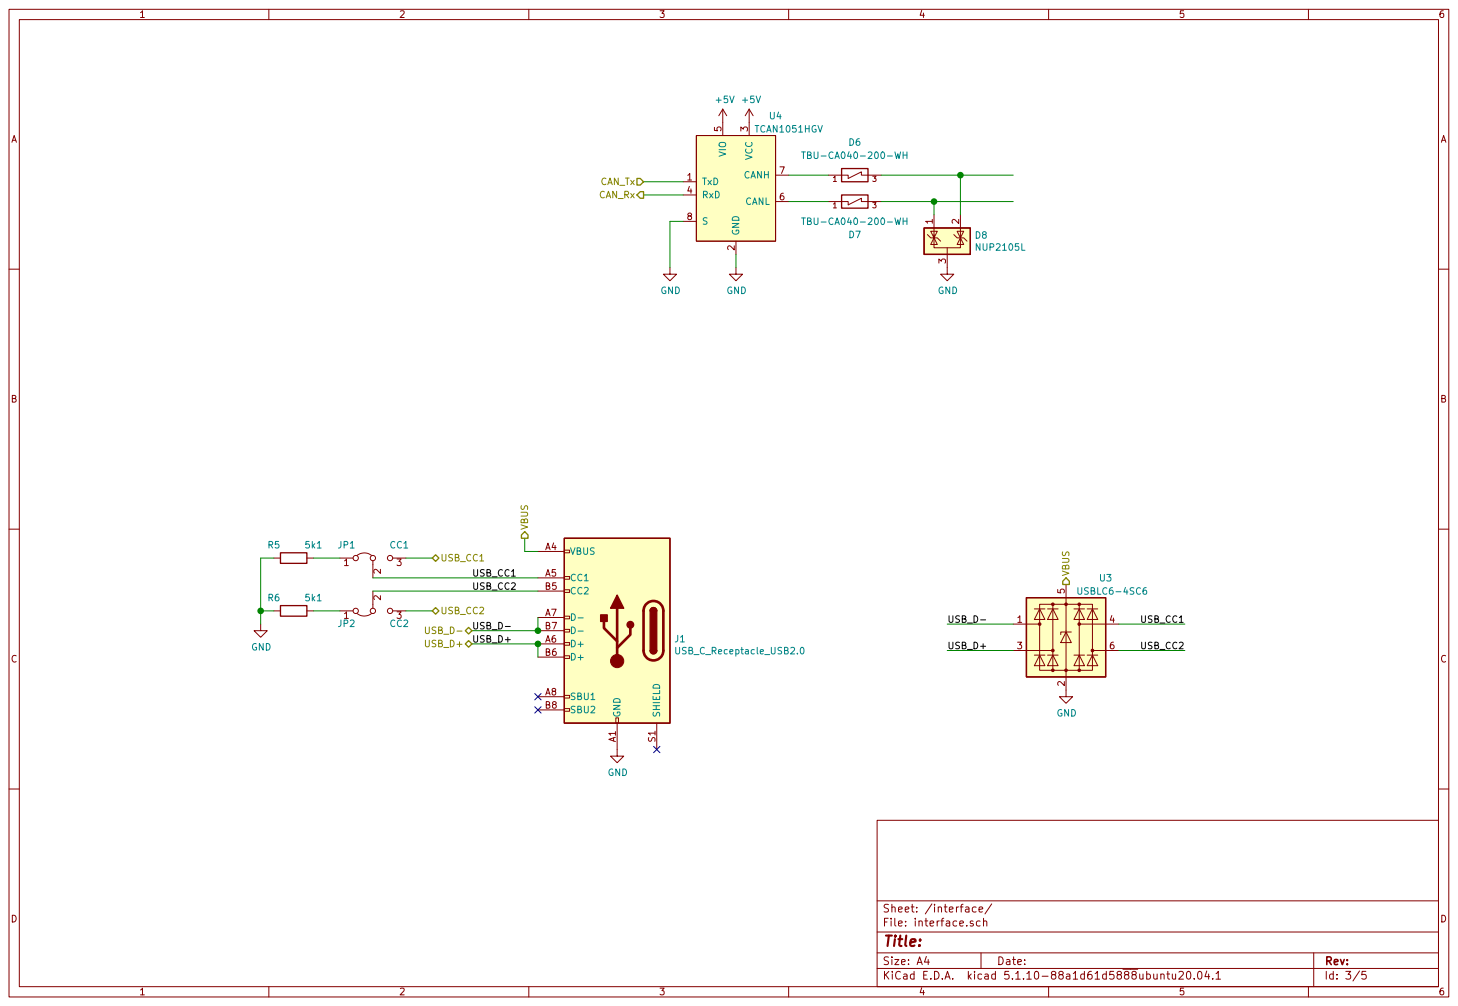
[picture p18: page 3]

Id: 3/5 Title: File: interface.sch Sheet: /interface/

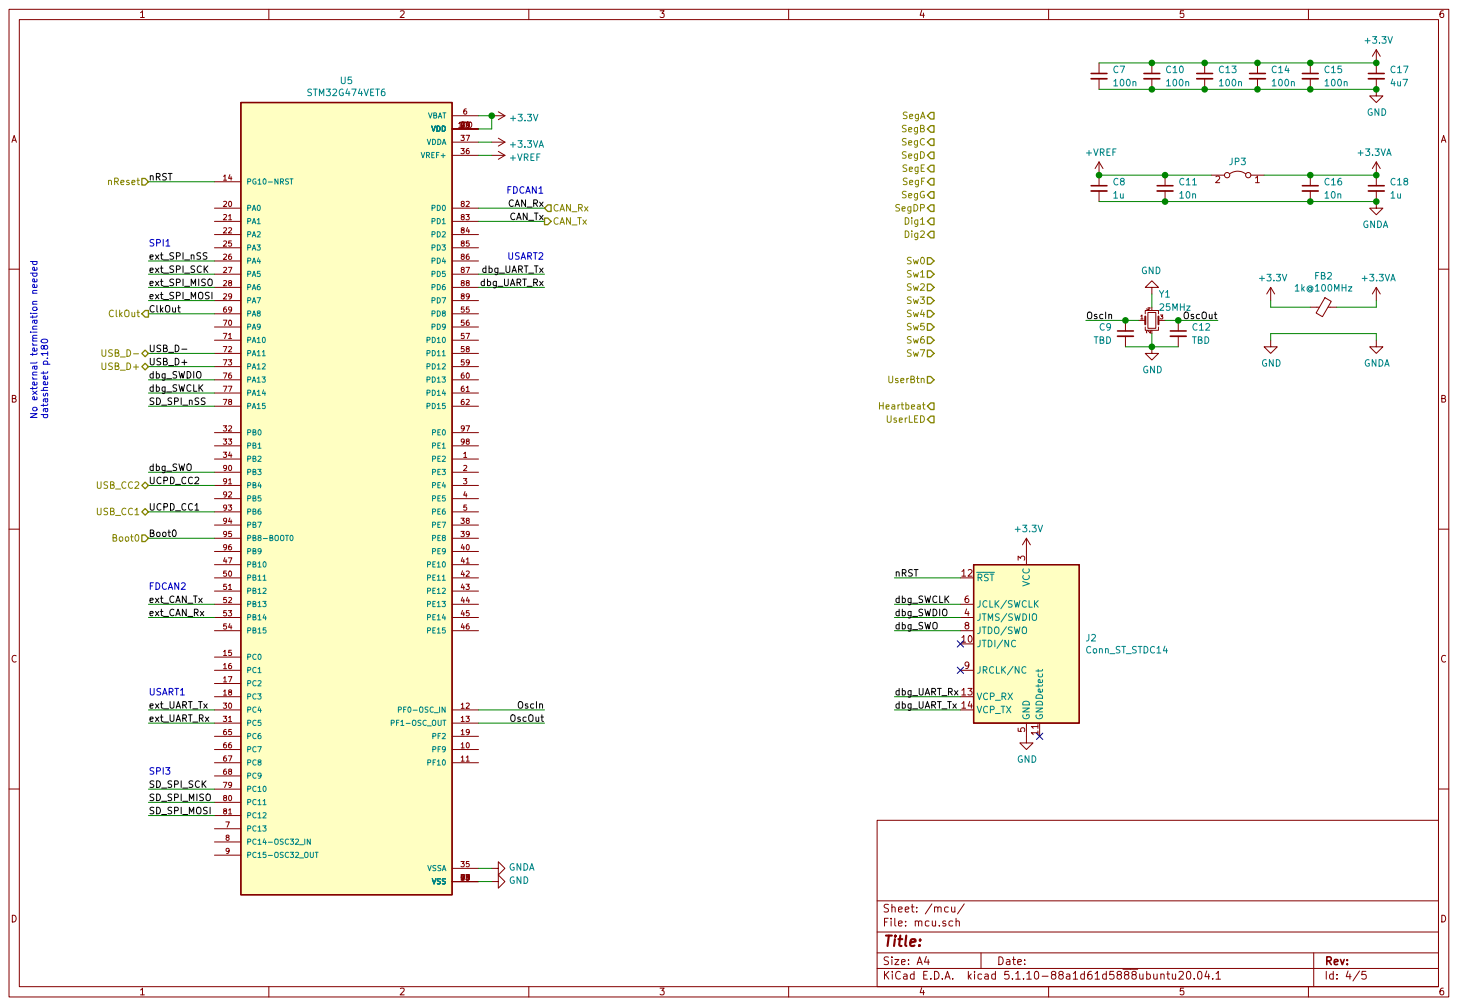
[picture p19: page 4]

Id: 4/5 Title: File: mcu.sch Sheet: /mcu/

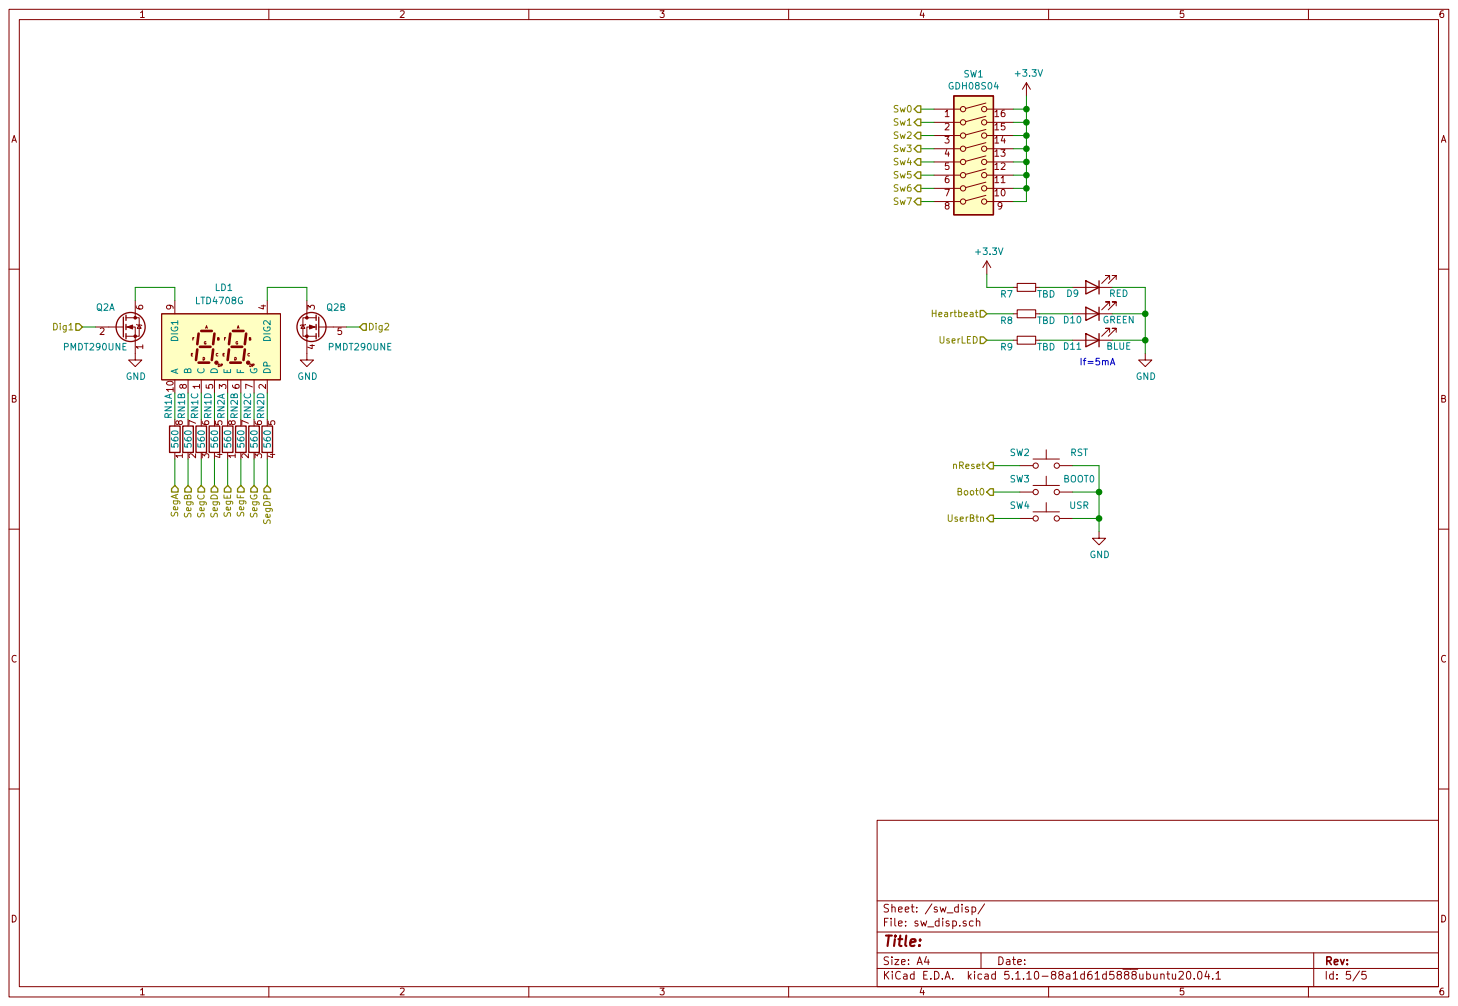
[picture p20: page 5]

Heartbeat SegA SegB SegC SegD SegE SegF
