BME-SBT/canbrd/hardware/hardware.kicad_pcb

## KiCad design hardware/hardware.kicad_pcb (2021-08-24)

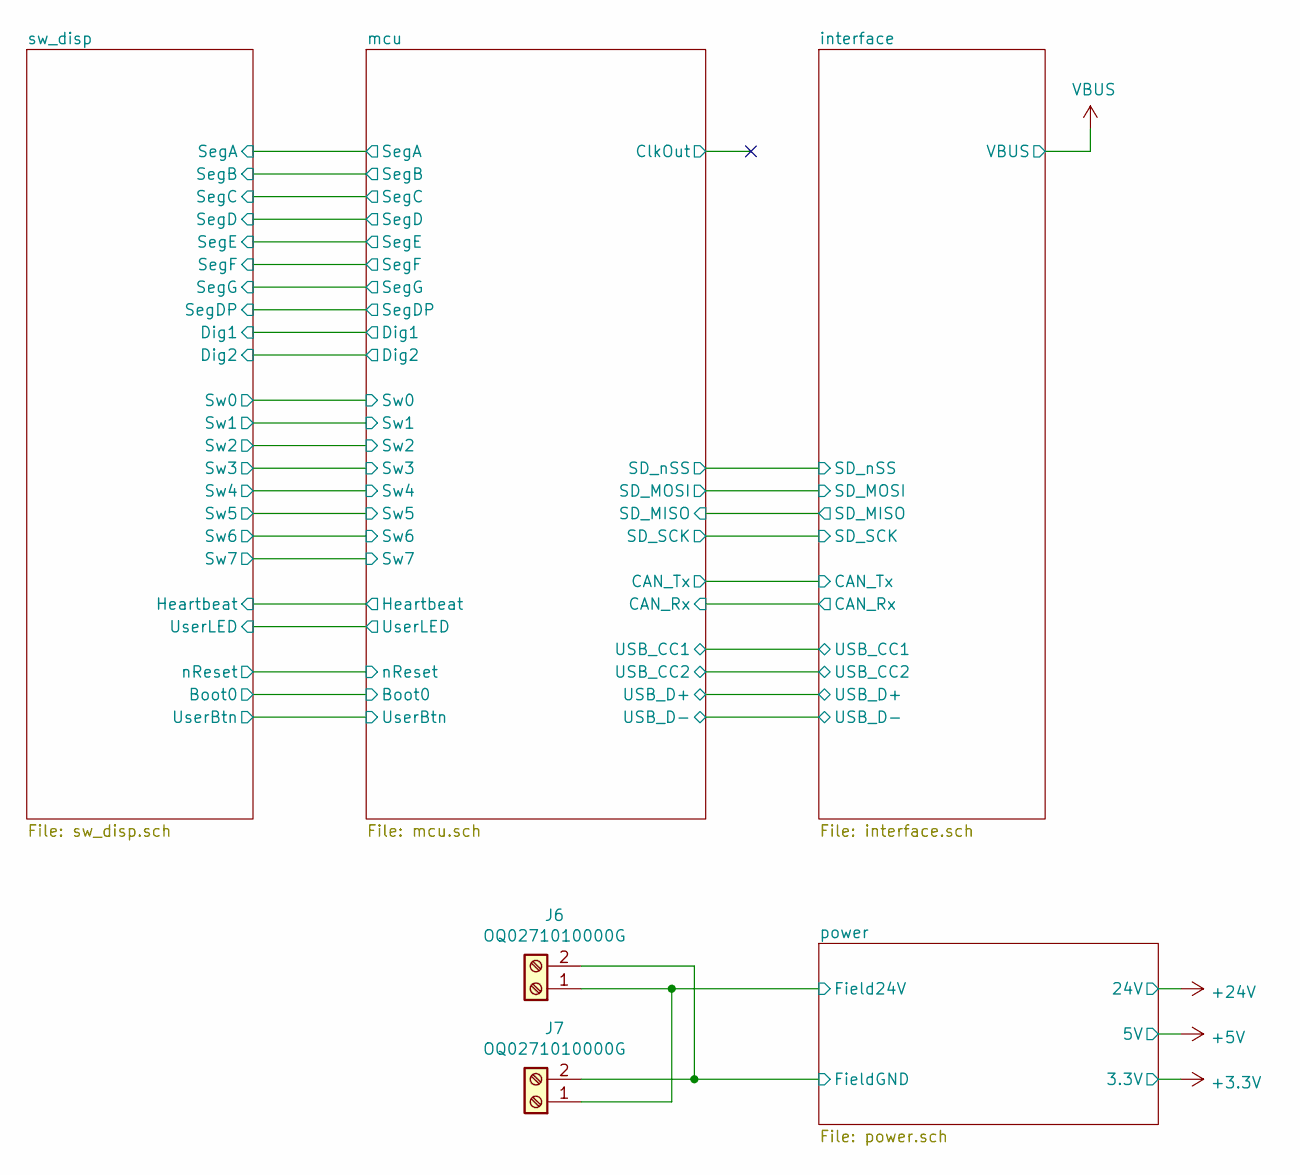
[picture p21: schematic hardware.sch]

Parts:
J6, J7: OQ0271010000G; AMPHENOL_OQ0271510000G

Connections:
/power/Field24V: J6.1, J7.1; also elsewhere on the board
/power/FieldGND: J6.2, J7.2; also elsewhere on the board

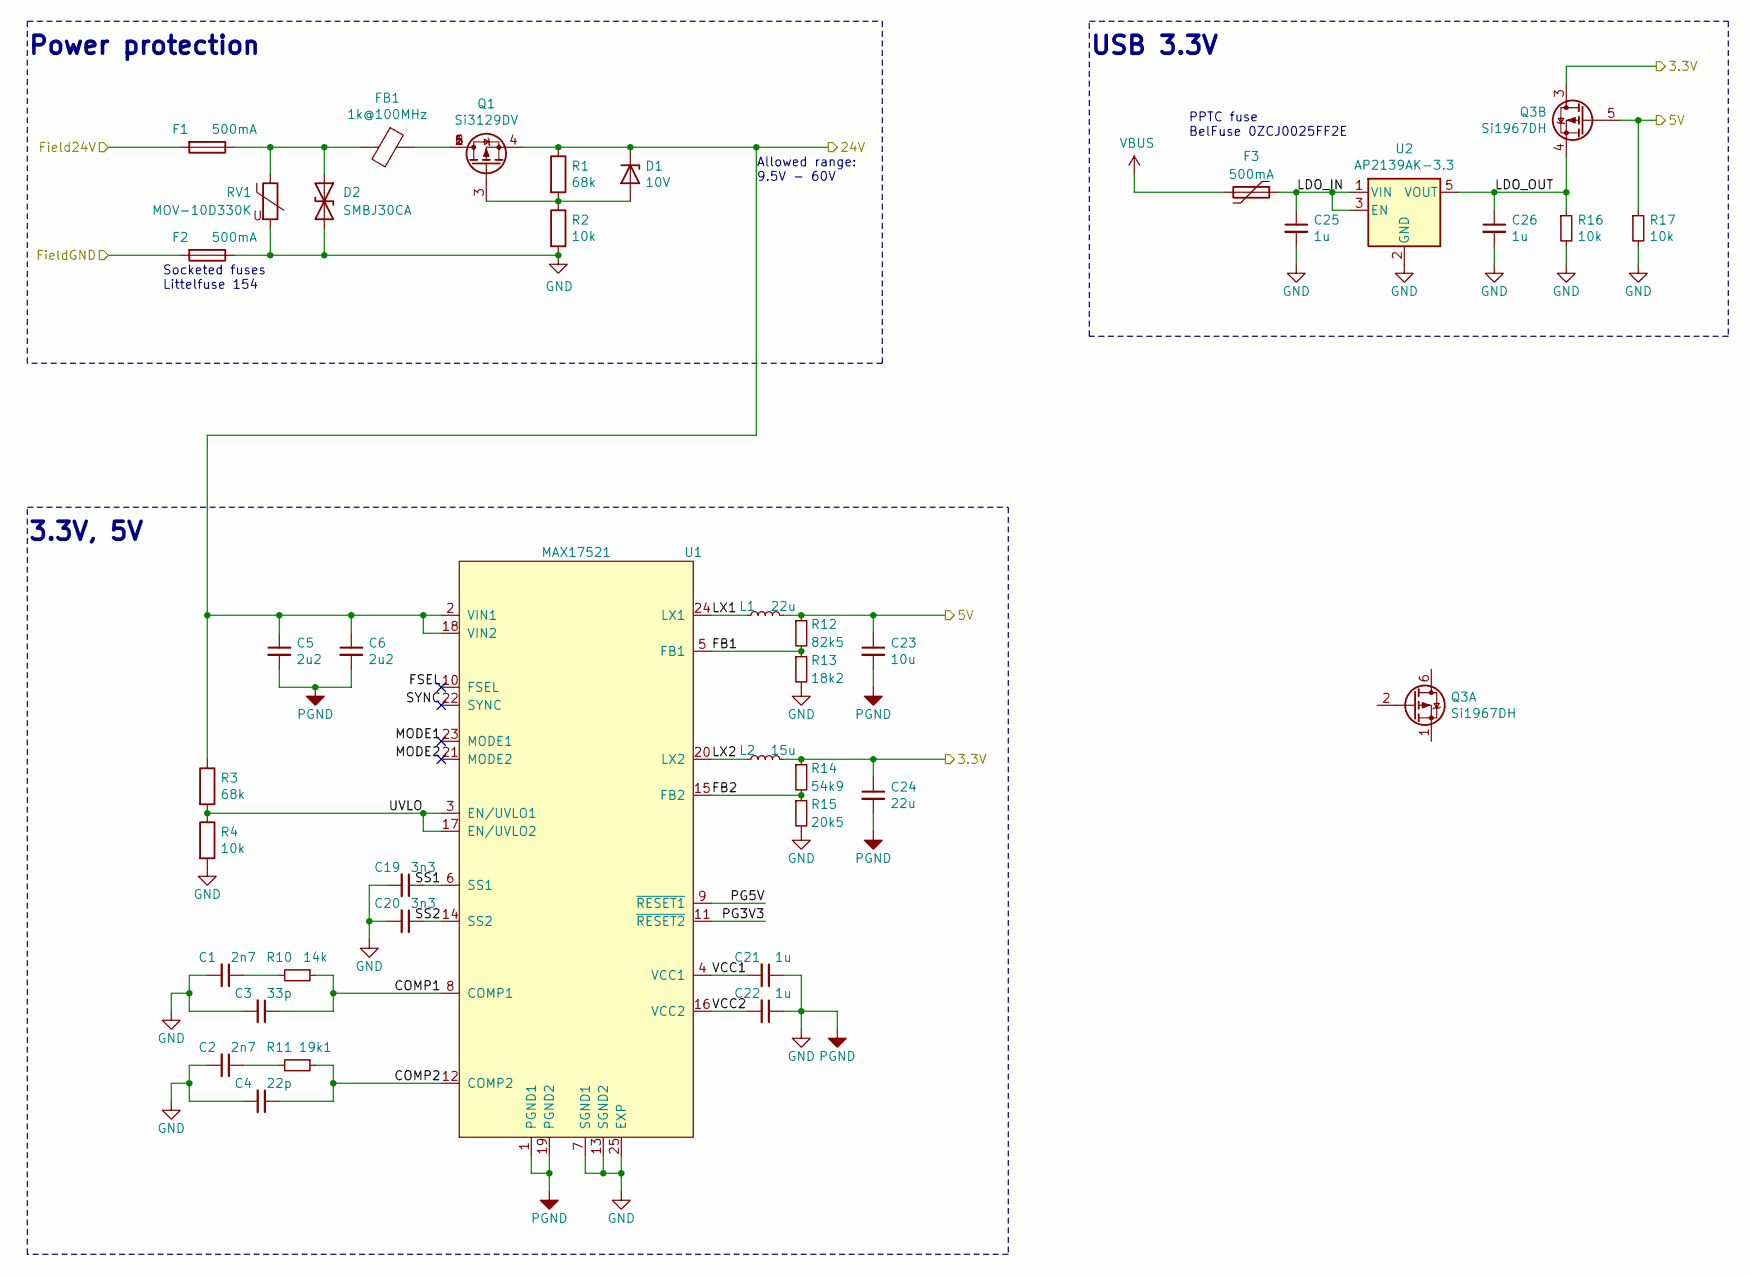
[picture p22: schematic power.sch]

Parts:
C1, C2: 2n7; C_0805_2012Metric
C3: 33p; C_0805_2012Metric
C4: 22p; C_0805_2012Metric
C5, C6: 2u2; C_0805_2012Metric
C19, C20: 3n3; C_0805_2012Metric
C21, C22, C25, C26: 1u; C_0805_2012Metric
C23: 10u; C_0805_2012Metric
C24: 22u; C_0805_2012Metric
D1: 10V; D_SOD-323F
D2: SMBJ30CA; D_SMB
F1, F2: 500mA; Littelfuse-154
F3: 500mA; Fuse_1206_3216Metric
FB1: 1k@100MHz; L_0805_2012Metric
L1: 22u; L_Taiyo-Yuden_NR-80xx_HandSoldering; PartNo TaiyoYuden NRS8040T220MJGJ
L2: 15u; L_Taiyo-Yuden_NR-80xx_HandSoldering; PartNo TaiyoYuden NRS8040T150MJGJ
Q1: Si3129DV; TSOP-6_1.65x3.05mm_P0.95mm
Q3: Si1967DH; SOT-363_SC-70-6_Handsoldering
R1, R3: 68k; R_0805_2012Metric
R2, R4, R16, R17: 10k; R_0805_2012Metric
R10: 14k; R_0805_2012Metric
R11: 19k1; R_0805_2012Metric
R12: 82k5; R_0805_2012Metric
R13: 18k2; R_0805_2012Metric
R14: 54k9; R_0805_2012Metric
R15: 20k5; R_0805_2012Metric
RV1: MOV-10D330K; RV_Disc_D12mm_W4.4mm_P7.5mm
U1: MAX17521; QFN50P500X400X80-25N
U2: AP2139AK-3.3; SOT-23-5

Connections:
+3V3: C24.1, L2.2, Q3.3 (D), R14.1; also elsewhere on the board
+5V: C23.1, L1.2, Q3.5 (G), R12.1, R17.1; also elsewhere on the board
+24V: C5.1, C6.1, D1.1 (K), Q1.4 (S), R1.1, R3.1, U1.2 (VIN1), U1.18 (VIN2)
/power/COMP1: C3.1, R10.1, U1.8 (COMP1)
/power/COMP2: C4.1, R11.1, U1.12 (COMP2)
/power/FB1: R12.2, R13.1, U1.5 (FB1)
/power/FB2: R14.2, R15.1, U1.15 (FB2)
/power/FSEL: U1.10 (FSEL)
/power/Field24V: F1.2; also elsewhere on the board
/power/FieldGND: F2.2; also elsewhere on the board
/power/LDO_IN: C25.1, F3.1, U2.1 (VIN), U2.3 (EN)
/power/LDO_OUT: C26.1, Q3.4 (S), R16.1, U2.5 (VOUT)
/power/LX1: L1.1, U1.24 (LX1)
/power/LX2: L2.1, U1.20 (LX2)
/power/MODE1: U1.23 (MODE1)
/power/MODE2: U1.21 (MODE2)
/power/PG3V3: U1.11 (~RESET2)
/power/PG5V: U1.9 (~RESET1)
/power/SS1: C19.1, U1.6 (SS1)
/power/SS2: C20.1, U1.14 (SS2)
/power/SYNC: U1.22 (SYNC)
/power/UVLO: R3.2, R4.1, U1.3 (EN/UVLO1), U1.17 (EN/UVLO2)
/power/VCC1: C21.2, U1.4 (VCC1)
/power/VCC2: C22.2, U1.16 (VCC2)
GND: C1.2, C2.2, C3.2, C4.2, C5.2, C6.2, C19.2, C20.2, C21.1, C22.1, C23.2, C24.2, C25.2, C26.2, D2.2 (A2), F2.1, R2.2, R4.2, R13.2, R15.2, R16.2, R17.2, RV1.2, U1.1 (PGND1), U1.7 (SGND1), U1.13 (SGND2), U1.19 (PGND2), U1.25 (EXP), U2.2 (GND); also elsewhere on the board
unnamed: C1.1, R10.2
unnamed: C2.1, R11.2
unnamed: D1.2 (A), Q1.3 (G), R1.2, R2.1
unnamed: D2.1 (A1), F1.1, FB1.2, RV1.1
unnamed: FB1.1, Q1.1 (D), Q1.2 (D), Q1.5 (D), Q1.6 (D)
VBUS: F3.2; also elsewhere on the board

Notes on the sheet:
Power protection
Socketed fuses Littelfuse 154
3.3V, 5V
PPTC fuse BelFuse 0ZCJ0025FF2E
Allowed range: 9.5V - 60V
USB 3.3V

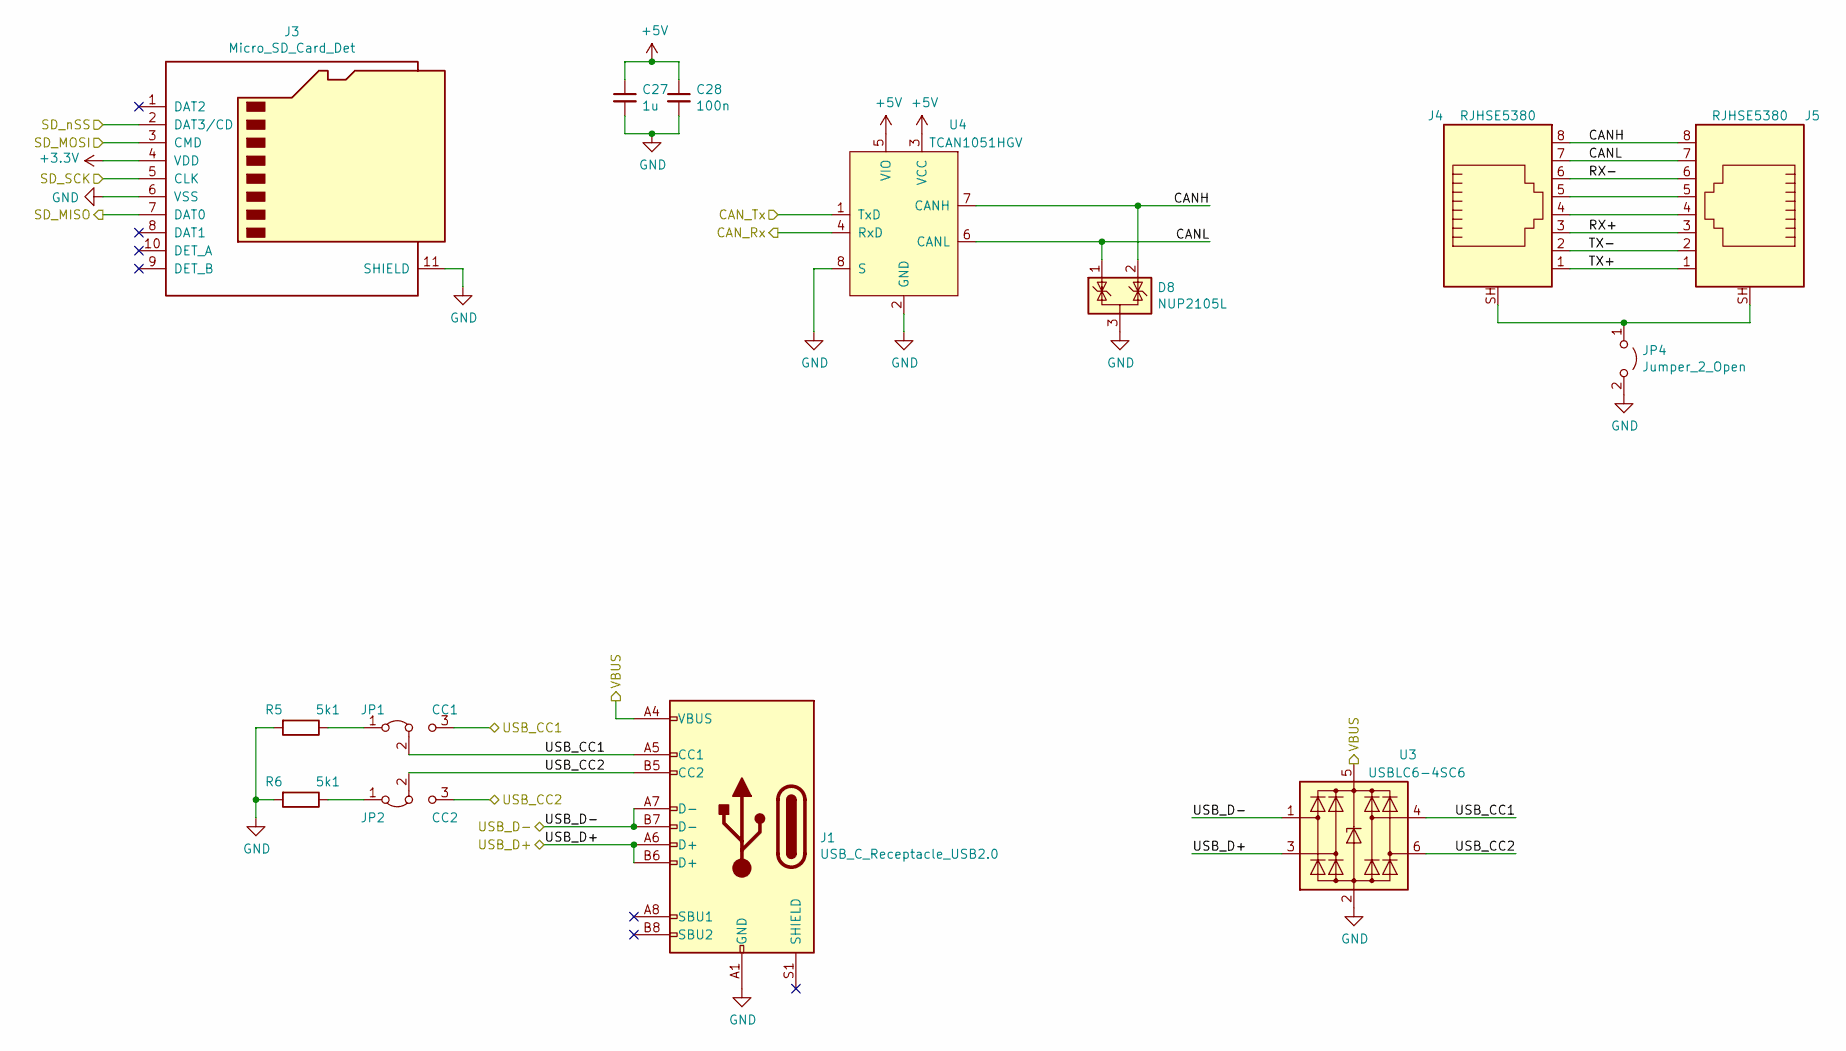
[picture p23: schematic interface.sch]

Parts:
C27: 1u; C_0805_2012Metric
C28: 100n; C_0805_2012Metric
D8: NUP2105L; SOT-23
J1: USB_C_Receptacle_USB2.0; USB_C_Receptacle_GCT_USB4085
J3: Micro_SD_Card_Det; microSD_HC_Molex_104031-0811
J4, J5: RJHSE5380; RJ45_Amphenol_RJHSE5380
JP1: CC1; SolderJumper-3_P1.3mm_Bridged12_RoundedPad1.0x1.5mm
JP2: CC2; SolderJumper-3_P1.3mm_Bridged12_RoundedPad1.0x1.5mm
JP4: Jumper_2_Open; SolderJumper-2_P1.3mm_Open_RoundedPad1.0x1.5mm
R5, R6: 5k1; R_0805_2012Metric
U3: USBLC6-4SC6; SOT-23-6
U4: TCAN1051HGV; SOIC-8_3.9x4.9mm_P1.27mm

Connections:
+3V3: J3.4 (VDD); also elsewhere on the board
+5V: C27.1, C28.1, U4.3 (VCC), U4.5 (VIO); also elsewhere on the board
/interface/CANH: D8.2 (K), J4.8, J5.8, U4.7 (CANH)
/interface/CANL: D8.1 (K), J4.7, J5.7, U4.6 (CANL)
/interface/CAN_Rx: U4.4 (RxD); also elsewhere on the board
/interface/CAN_Tx: U4.1 (TxD); also elsewhere on the board
/interface/RX+: J4.3, J5.3
/interface/RX-: J4.6, J5.6
/interface/SD_MISO: J3.7 (DAT0); also elsewhere on the board
/interface/SD_MOSI: J3.3 (CMD); also elsewhere on the board
/interface/SD_SCK: J3.5 (CLK); also elsewhere on the board
/interface/SD_nSS: J3.2 (DAT3/CD); also elsewhere on the board
/interface/TX+: J4.1, J5.1
/interface/TX-: J4.2, J5.2
/interface/USB_CC1: J1.A5 (CC1), JP1.2 (C), JP1.3 (B), U3.4 (I/O3); also elsewhere on the board
/interface/USB_CC2: J1.B5 (CC2), JP2.2 (C), JP2.3 (B), U3.6 (I/O4); also elsewhere on the board
/interface/USB_D+: J1.A6 (D+), J1.B6 (D+), U3.3 (I/O2); also elsewhere on the board
/interface/USB_D-: J1.A7 (D-), J1.B7 (D-), U3.1 (I/O1); also elsewhere on the board
GND: C27.2, C28.2, D8.3 (A), J1.A1 (GND), J1.A12 (GND), J1.B1 (GND), J1.B12 (GND), J3.6 (VSS), J3.11 (SHIELD), JP4.2 (B), R5.2, R6.2, U3.2 (GND), U4.2 (GND), U4.8 (S); also elsewhere on the board
unnamed: J4.4, J5.4
unnamed: J4.5, J5.5
unnamed: J4.SH, J5.SH, JP4.1 (A)
unnamed: JP1.1 (A), R5.1
unnamed: JP2.1 (A), R6.1
VBUS: J1.A4 (VBUS), J1.A9 (VBUS), J1.B4 (VBUS), J1.B9 (VBUS), U3.5 (VBUS); also elsewhere on the board

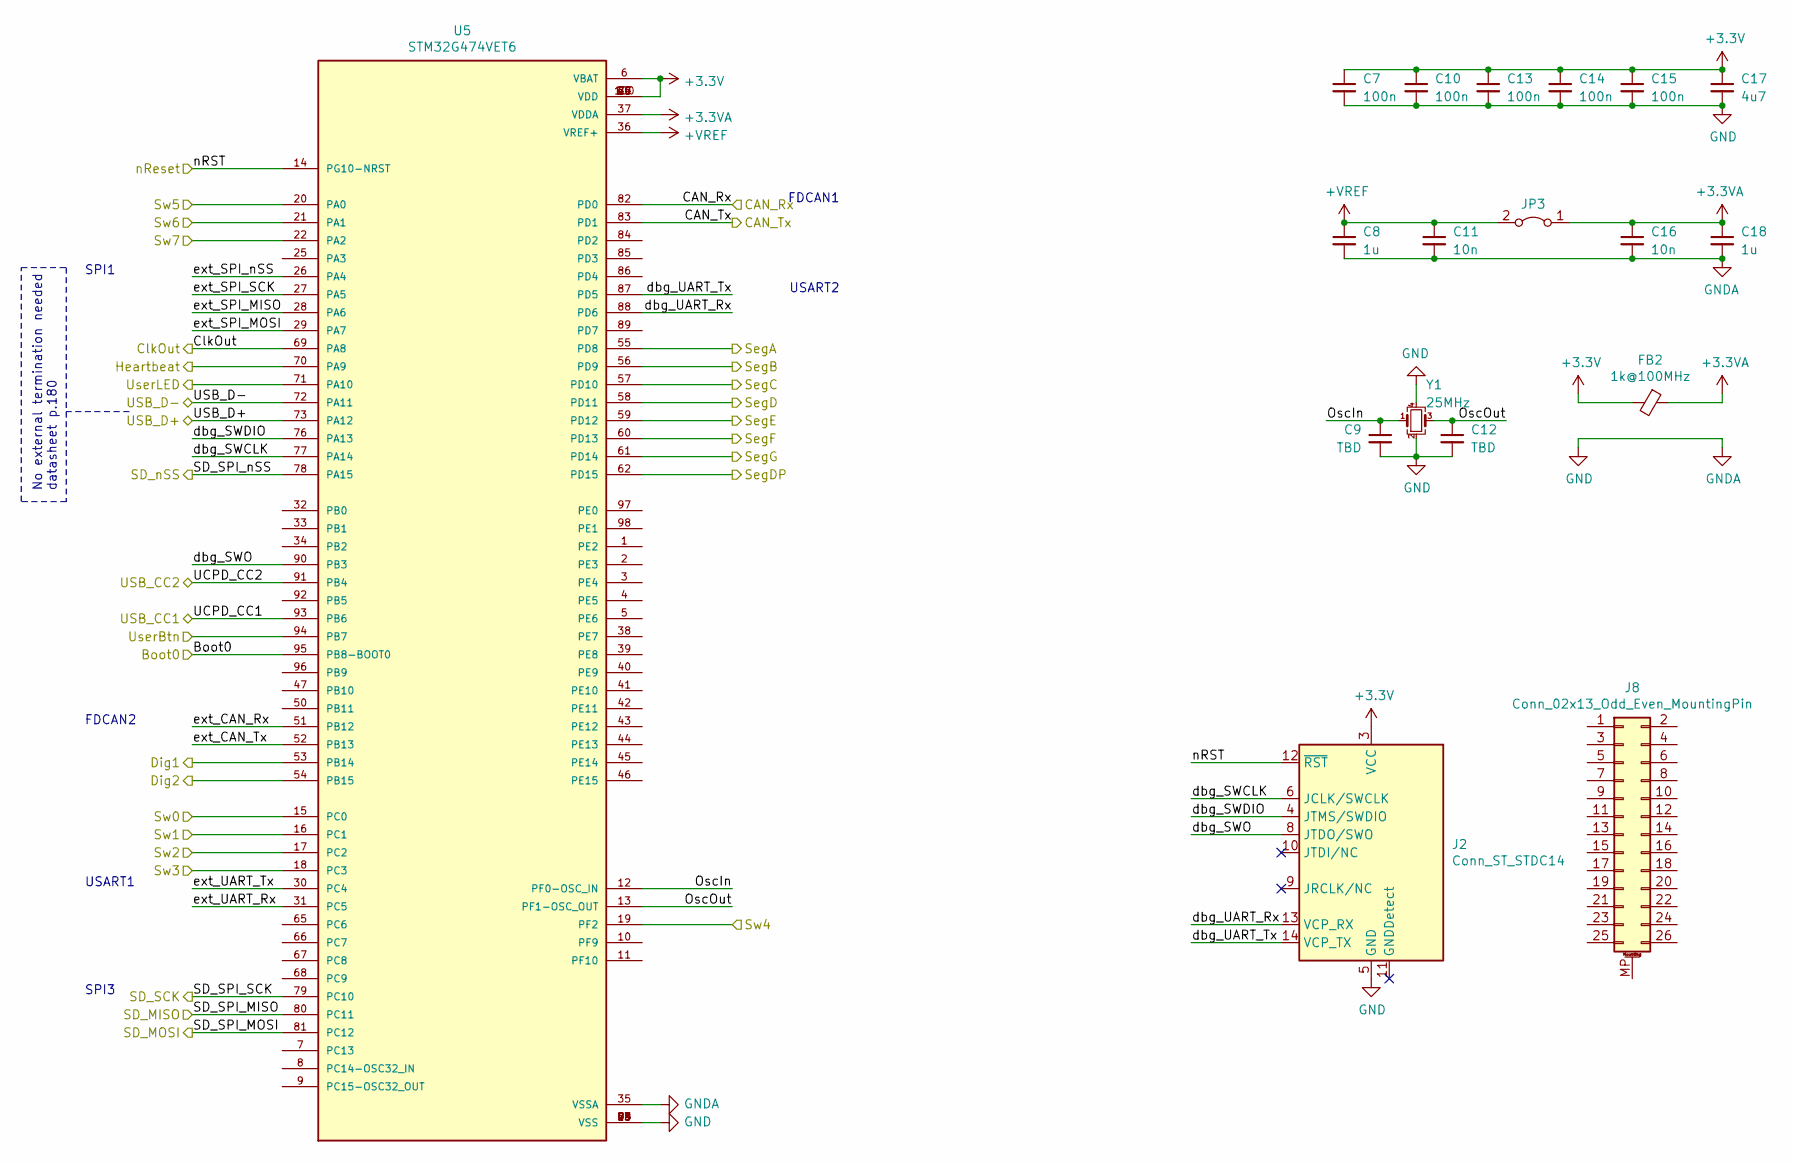
[picture p24: schematic mcu.sch]

Parts:
C7, C10, C13, C14, C15: 100n; C_0805_2012Metric
C8, C18: 1u; C_0805_2012Metric
C9, C12: TBD; C_0805_2012Metric
C11, C16: 10n; C_0805_2012Metric
C17: 4u7; C_0805_2012Metric
FB2: 1k@100MHz; L_0805_2012Metric
J2: Conn_ST_STDC14; PinHeader_2x07_P1.27mm_Vertical_SMD
J8: Conn_02x13_Odd_Even_MountingPin; IDC-Header_2x13-1MP_P2.54mm_Latch_Horizontal
JP3: Jumper_2_Bridged; SolderJumper-2_P1.3mm_Bridged_RoundedPad1.0x1.5mm
U5: STM32G474VET6; TQFP-100_14x14mm_P0.5mm; PARTREV 2
Y1: 25MHz; Crystal_SMD_3225-4Pin_3.2x2.5mm_HandSoldering

Connections:
+3.3VA: C16.1, C18.1, FB2.1, JP3.1 (A), U5.37 (VDDA)
+3V3: C7.1, C10.1, C13.1, C14.1, C15.1, C17.1, FB2.2, J2.3 (VCC), U5.6 (VBAT), U5.24 (VDD), U5.49 (VDD), U5.64 (VDD), U5.75 (VDD), U5.100 (VDD); also elsewhere on the board
/interface/CAN_Rx: U5.82 (PD0); also elsewhere on the board
/interface/CAN_Tx: U5.83 (PD1); also elsewhere on the board
/interface/SD_MISO: U5.80 (PC11); also elsewhere on the board
/interface/SD_MOSI: U5.81 (PC12); also elsewhere on the board
/interface/SD_SCK: U5.79 (PC10); also elsewhere on the board
/interface/SD_nSS: U5.78 (PA15); also elsewhere on the board
/interface/USB_CC1: U5.93 (PB6); also elsewhere on the board
/interface/USB_CC2: U5.91 (PB4); also elsewhere on the board
/interface/USB_D+: U5.73 (PA12); also elsewhere on the board
/interface/USB_D-: U5.72 (PA11); also elsewhere on the board
/mcu/Boot0: U5.95 (PB8-BOOT0); also elsewhere on the board
/mcu/ClkOut: U5.69 (PA8)
/mcu/Dig1: U5.53 (PB14); also elsewhere on the board
/mcu/Dig2: U5.54 (PB15); also elsewhere on the board
/mcu/Heartbeat: U5.70 (PA9); also elsewhere on the board
/mcu/OscIn: C9.1, U5.12 (PF0-OSC_IN), Y1.1
/mcu/OscOut: C12.1, U5.13 (PF1-OSC_OUT), Y1.3
/mcu/SegA: U5.55 (PD8); also elsewhere on the board
/mcu/SegB: U5.56 (PD9); also elsewhere on the board
/mcu/SegC: U5.57 (PD10); also elsewhere on the board
/mcu/SegD: U5.58 (PD11); also elsewhere on the board
/mcu/SegDP: U5.62 (PD15); also elsewhere on the board
/mcu/SegE: U5.59 (PD12); also elsewhere on the board
/mcu/SegF: U5.60 (PD13); also elsewhere on the board
/mcu/SegG: U5.61 (PD14); also elsewhere on the board
/mcu/Sw0: U5.15 (PC0); also elsewhere on the board
/mcu/Sw1: U5.16 (PC1); also elsewhere on the board
/mcu/Sw2: U5.17 (PC2); also elsewhere on the board
/mcu/Sw3: U5.18 (PC3); also elsewhere on the board
/mcu/Sw4: U5.19 (PF2); also elsewhere on the board
/mcu/Sw5: U5.20 (PA0); also elsewhere on the board
/mcu/Sw6: U5.21 (PA1); also elsewhere on the board
/mcu/Sw7: U5.22 (PA2); also elsewhere on the board
/mcu/UserBtn: U5.94 (PB7); also elsewhere on the board
/mcu/UserLED: U5.71 (PA10); also elsewhere on the board
/mcu/dbg_SWCLK: J2.6 (JCLK/SWCLK), U5.77 (PA14)
/mcu/dbg_SWDIO: J2.4 (JTMS/SWDIO), U5.76 (PA13)
/mcu/dbg_SWO: J2.8 (JTDO/SWO), U5.90 (PB3)
/mcu/dbg_UART_Rx: J2.13 (VCP_RX), U5.88 (PD6)
/mcu/dbg_UART_Tx: J2.14 (VCP_TX), U5.87 (PD5)
/mcu/ext_CAN_Rx: U5.51 (PB12)
/mcu/ext_CAN_Tx: U5.52 (PB13)
/mcu/ext_SPI_MISO: U5.28 (PA6)
/mcu/ext_SPI_MOSI: U5.29 (PA7)
/mcu/ext_SPI_SCK: U5.27 (PA5)
/mcu/ext_SPI_nSS: U5.26 (PA4)
/mcu/ext_UART_Rx: U5.31 (PC5)
/mcu/ext_UART_Tx: U5.30 (PC4)
/mcu/nReset: J2.12 (~RST), U5.14 (PG10-NRST); also elsewhere on the board
GND: C7.2, C8.2, C9.2, C10.2, C11.2, C12.2, C13.2, C14.2, C15.2, C16.2, C17.2, C18.2, J2.5 (GND), J2.7 (GND), U5.23 (VSS), U5.35 (VSSA), U5.48 (VSS), U5.63 (VSS), U5.74 (VSS), U5.99 (VSS), Y1.2, Y1.4; also elsewhere on the board

Notes on the sheet:
SPI1
FDCAN2
USART1
USART2
SPI3
FDCAN1
No external termination needed datasheet p.180

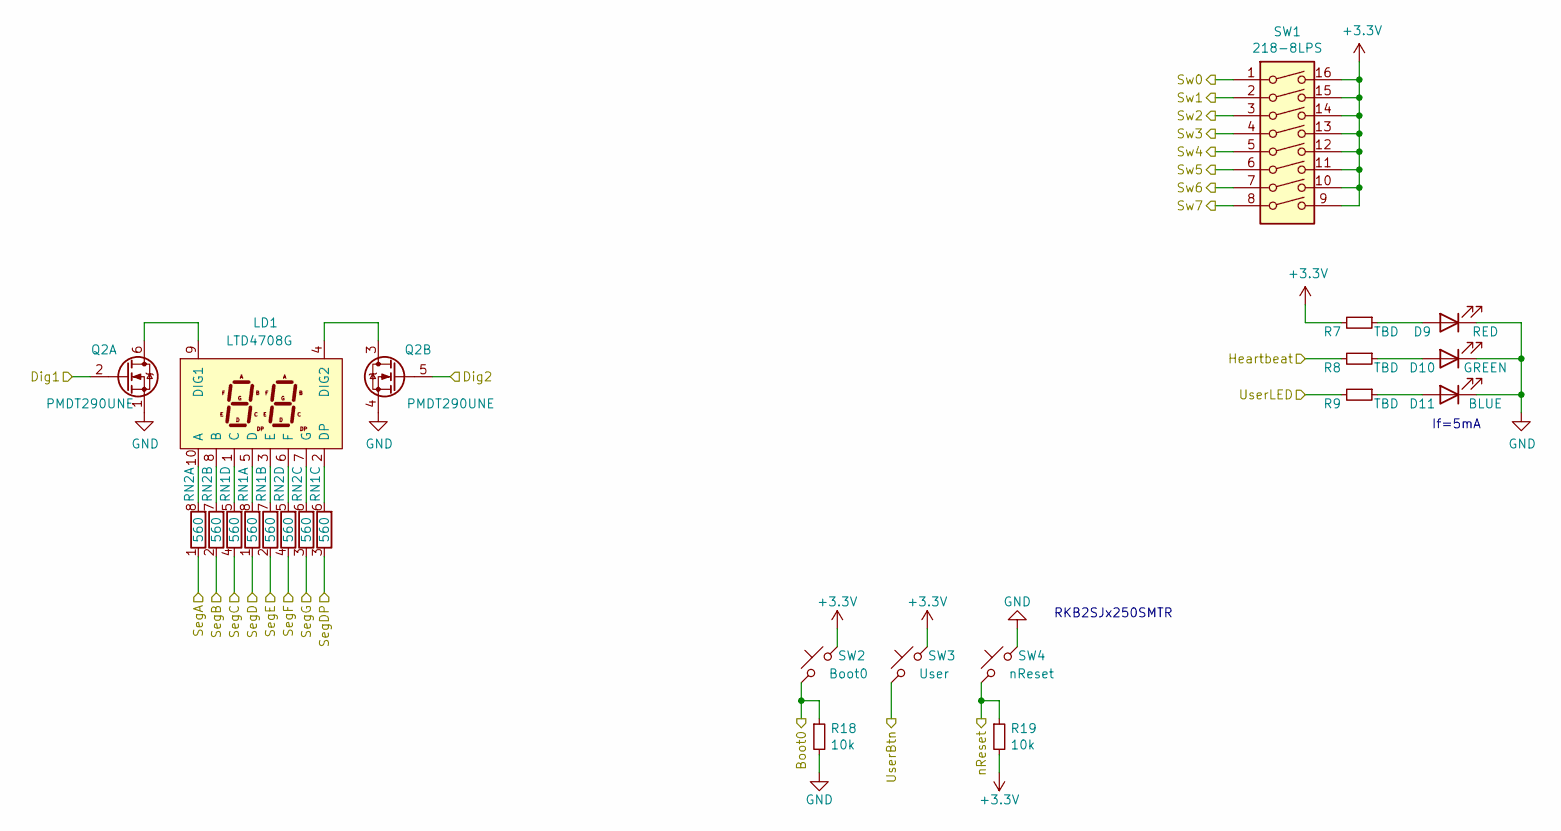
[picture p25: schematic sw_disp.sch]

Parts:
D9: RED; LED_0805_2012Metric
D10: GREEN; LED_0805_2012Metric
D11: BLUE; LED_0805_2012Metric
LD1: LTD4708G; LED_LTD-4708G
Q2: PMDT290UNE; SOT-666
R7, R8, R9: TBD; R_0805_2012Metric
R18, R19: 10k; R_0805_2012Metric
RN1, RN2: 560; R_Array_Concave_4x0603
SW1: 218-8LPS; SW_DIP_SPSTx08_Slide_KingTek_DSHP08TS_W7.62mm_P1.27mm
SW2: Boot0; RKB2SJ
SW3: User; RKB2SJ
SW4: nReset; RKB2SJ

Connections:
+3V3: R7.2, R19.2, SW1.9, SW1.10, SW1.11, SW1.12, SW1.13, SW1.14, SW1.15, SW1.16, SW2.2, SW3.2; also elsewhere on the board
/mcu/Boot0: R18.1, SW2.1; also elsewhere on the board
/mcu/Dig1: Q2.2 (G); also elsewhere on the board
/mcu/Dig2: Q2.5 (G); also elsewhere on the board
/mcu/Heartbeat: R8.2; also elsewhere on the board
/mcu/SegA: RN2.1 (R1.1); also elsewhere on the board
/mcu/SegB: RN2.2 (R2.1); also elsewhere on the board
/mcu/SegC: RN1.4 (R4.1); also elsewhere on the board
/mcu/SegD: RN1.1 (R1.1); also elsewhere on the board
/mcu/SegDP: RN1.3 (R3.1); also elsewhere on the board
/mcu/SegE: RN1.2 (R2.1); also elsewhere on the board
/mcu/SegF: RN2.4 (R4.1); also elsewhere on the board
/mcu/SegG: RN2.3 (R3.1); also elsewhere on the board
/mcu/Sw0: SW1.1; also elsewhere on the board
/mcu/Sw1: SW1.2; also elsewhere on the board
/mcu/Sw2: SW1.3; also elsewhere on the board
/mcu/Sw3: SW1.4; also elsewhere on the board
/mcu/Sw4: SW1.5; also elsewhere on the board
/mcu/Sw5: SW1.6; also elsewhere on the board
/mcu/Sw6: SW1.7; also elsewhere on the board
/mcu/Sw7: SW1.8; also elsewhere on the board
/mcu/UserBtn: SW3.1; also elsewhere on the board
/mcu/UserLED: R9.2; also elsewhere on the board
/mcu/nReset: R19.1, SW4.1; also elsewhere on the board
GND: D9.1 (K), D10.1 (K), D11.1 (K), Q2.1 (S), Q2.4 (S), R18.2, SW4.2; also elsewhere on the board
unnamed: D9.2 (A), R7.1
unnamed: D10.2 (A), R8.1
unnamed: D11.2 (A), R9.1
unnamed: LD1.1 (C), RN1.5 (R4.2)
unnamed: LD1.2 (DP), RN1.6 (R3.2)
unnamed: LD1.3 (E), RN1.7 (R2.2)
unnamed: LD1.4 (DIG2), Q2.3 (D)
unnamed: LD1.5 (D), RN1.8 (R1.2)
unnamed: LD1.6 (F), RN2.5 (R4.2)
unnamed: LD1.7 (G), RN2.6 (R3.2)
unnamed: LD1.8 (B), RN2.7 (R2.2)
unnamed: LD1.9 (DIG1), Q2.6 (D)
unnamed: LD1.10 (A), RN2.8 (R1.2)

Notes on the sheet:
If=5mA
RKB2SJx250SMTR

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
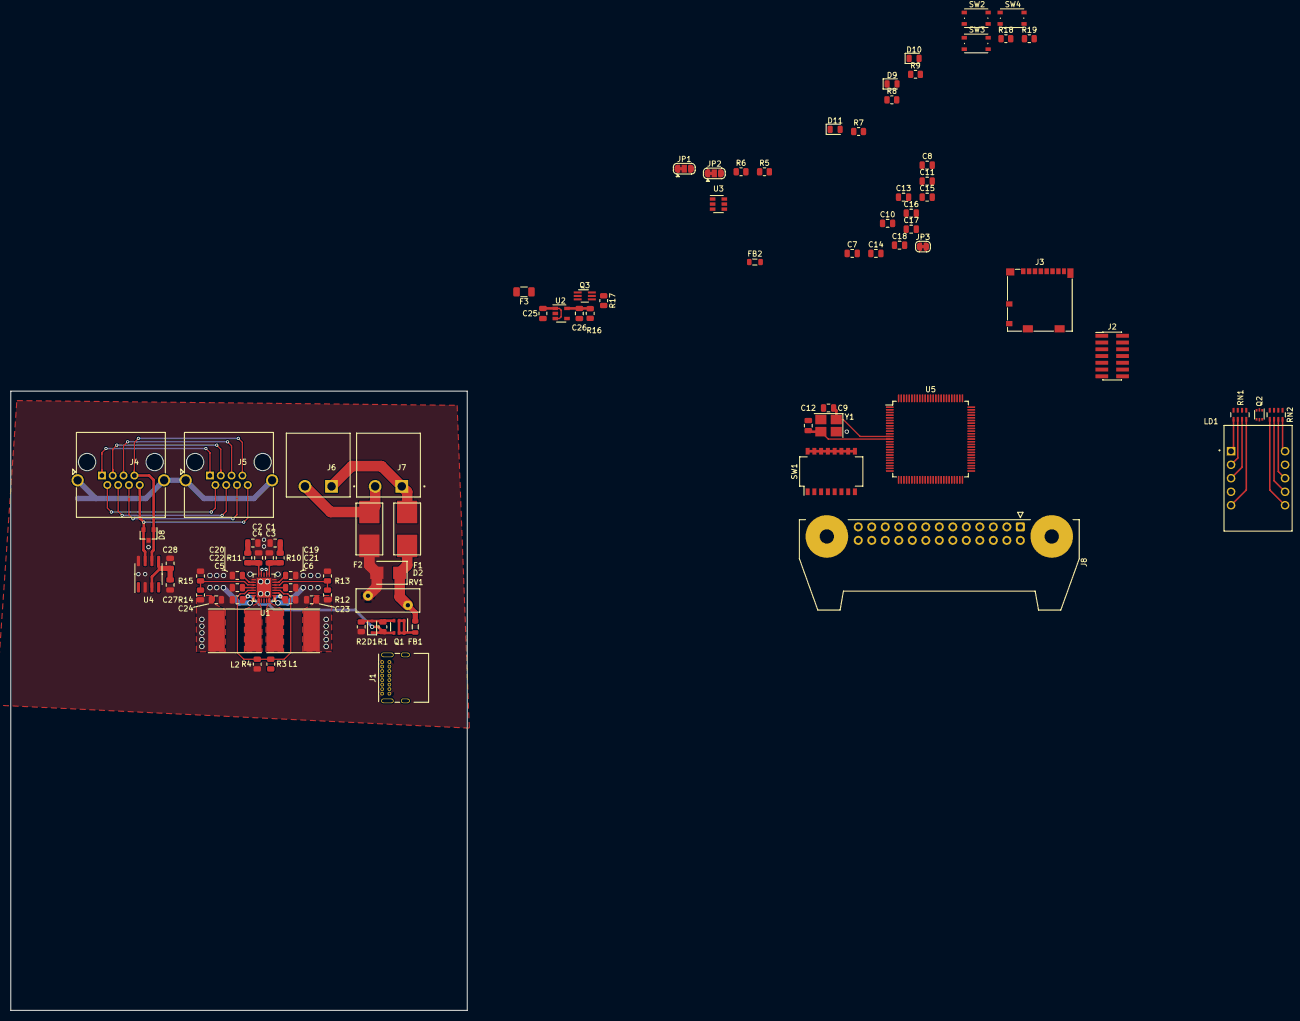
[picture p26: board hardware.kicad_pcb from above]

Board: 2 copper layers, 85.9 x 116.5 mm, 89 parts (1 on the bottom side), 91 nets.
