BME-SBT/canbrd/firmware/test/test.ioc

Mcu.UserName=STM32G474VETx
PA0.GPIO_Label=Sw5
PA0.Signal=GPIO_Input
PA1.GPIO_Label=Sw6
PA1.Signal=GPIO_Input
PA10.GPIO_Label=UserLED
PA10.Signal=GPIO_Output
PA11.Signal=USB_DM
PA12.Signal=USB_DP
PA13.Signal=SYS_JTMS-SWDIO
PA14.Signal=SYS_JTCK-SWCLK
PA15.Signal=SPI3_NSS
PA2.GPIO_Label=Sw7
PA2.Signal=GPIO_Input
PA4.GPIO_Label=ext_SPI_nSS
PA4.Signal=SPI1_NSS
PA5.GPIO_Label=ext_SPI_SCK
PA5.Signal=SPI1_SCK
PA6.GPIO_Label=ext_SPI_MISO
PA6.Signal=SPI1_MISO
PA7.GPIO_Label=ext_SPI_MOSI
PA7.Signal=SPI1_MOSI
PA8.Signal=RCC_MCO
PA9.GPIO_Label=Heartbeat
PA9.Signal=GPIO_Output
PB12.GPIO_Label=ext_CAN_Rx
PB12.Signal=FDCAN2_RX
PB13.GPIO_Label=ext_CAN_Tx
PB13.Signal=FDCAN2_TX
PB14.GPIO_Label=Dig1
PB14.Signal=GPIO_Output
PB15.GPIO_Label=Dig2
PB15.Signal=GPIO_Output
PB3.Signal=SYS_JTDO-SWO
PB4.Signal=UCPD1_CC2
PB6.Signal=UCPD1_CC1
PB7.GPIO_Label=UserBtn
PB7.Signal=GPIO_Input
PC0.GPIO_Label=Sw0
PC0.Signal=GPIO_Input
PC1.GPIO_Label=Sw1
PC1.Signal=GPIO_Input
PC10.Signal=SPI3_SCK
PC11.Signal=SPI3_MISO
PC12.Signal=SPI3_MOSI
PC2.GPIO_Label=Sw2
PC2.Signal=GPIO_Input
PC3.GPIO_Label=Sw3
PC3.Signal=GPIO_Input
PC4.GPIO_Label=ext_UART_Tx
PC4.Signal=USART1_TX
PC5.GPIO_Label=ext_UART_Rx
PC5.Signal=USART1_RX
PC6.GPIO_Label=ext_I2C_SCL
PC6.Signal=I2C4_SCL
PC7.GPIO_Label=ext_I2C_SDA
PC7.Signal=I2C4_SDA
PD0.Signal=FDCAN1_RX
PD1.Signal=FDCAN1_TX
PD10.GPIO_Label=SegC
PD10.Signal=GPIO_Output
PD11.GPIO_Label=SegD
PD11.Signal=GPIO_Output
PD12.GPIO_Label=SegE
PD12.Signal=GPIO_Output
PD13.GPIO_Label=SegF
PD13.Signal=GPIO_Output
PD14.GPIO_Label=SegG
PD14.Signal=GPIO_Output
PD15.GPIO_Label=SegDP
PD15.Signal=GPIO_Output
PD5.Signal=USART2_TX
PD6.Signal=USART2_RX
PD8.GPIO_Label=SegA
PD8.Signal=GPIO_Output
PD9.GPIO_Label=SegB
PD9.Signal=GPIO_Output
PE2.Signal=SPI4_SCK
PE3.Signal=SPI4_NSS
PE5.Signal=SPI4_MISO
PE6.Signal=SPI4_MOSI
PF0-OSC_IN.Signal=RCC_OSC_IN
PF1-OSC_OUT.Signal=RCC_OSC_OUT
PF2.GPIO_Label=Sw4
PF2.Signal=GPIO_Input
