BME-SBT/canbrd/(commit log)

2021-08-04 things changed
    [mcu_g4.xlsx]
2021-08-08 updated to stm32g474vetx
2021-08-16 Start hardware
    [STM32G474VET6.step, hardware.kicad_pcb, hardware.sch, interface.sch, mcu.sch, power.sch]
2021-08-17 WIP: schematic
    [150080M153000.step, LTD-4708G.step, c-1571983-10-b-3d.stp, can_transciever.xlsx, hardware.sch, interface.sch, mcu.sch, power.sch]
2021-08-19 Change power protection
2021-08-19 Power looks nice
    [power.sch]
2021-08-22 Changed power again
    [hardware.sch, interface.sch, mcu.sch, power.sch, sw_disp.sch]
2021-08-23 Started routing
    [0154.500DR.STEP, 0ZCJ0005FF2E.STEP, 1040310811.stp, 218-8.STEP, 71922_y26_asm.stp, NRS8040.FCStd, OQ0271510000G.step, RKB2SJM250SMTR LFS-color.stp]
2021-08-24 Power routing
    [interface.sch, power.sch, sw_disp.sch]
