BME-SBT/canbrd/(notices)

Notices in the files:
hardware/parts/RKB2SJ/RKB2SJM250SMTR LFS.stp:
FILE_NAME( 'e:/temp/worker_128/temp/exporttempdir_5952_492_uyLlD/format_0/RKB2SJM250SMTR LFS.stp', '2021-08-23T14:48:41', ( 'License CC BY-ND 4.0' ), ( 'CADENAS' ), ' ', 'PARTsolutions', ' ' );
